mthudaa/10bit_SAR-ADC_ITS/xschem/x10b_adc.pdf

### x10b_adc.sch

# cdac

x2

### VDD

### VSS

### VCM

CF[0:9]

### SWP_IN[0:9]

### SWN_IN[0:9]

### VCP

### VCN

# th_dif_sw

x3

### VDD

### VSS

CK

### CKB

### VIP

### VIN

### VCP

### VCN

## SWP[0:9] SWN[0:9] DATA[0:9] CKO

## CKSB

## CKS

## CKSB

## CKS

## VDDD VSSD

## RDY CMP_P CMP_N

## CMP_P CMP_N

## VINP VINN

## VCP VCN

## VCP VCN

## VCP VCN

## SWP[0:9] SWN[0:9]

CF[0:9]

## VDDA VSSA

## VDDA VSSA

## CLK

## VDDR VSSR VCM

# VDDA VSSA

# CLK VINP VINN

# DATA[0:9] CKO

CF[0:9]

# VCM

EN

EN | RDY

## CLK

# tdc

x1

### CLK

### VDD

### VSS

### VINP

### VINN

### OUTP

### OUTN

### RDY

# sar10b

x4

### VPWR

### VGND

### CLK

### RDY

### CMP_P

### CMP_N

EN

### CKS

### CKSB

CF[0:9]

### SWP[0:9]

### SWN[0:9]

### DATA[0:9]

### CKO

# VDDD VSSD VDDR VSSR

s1

.include /usr/local/share/pdk/sky130A/libs.ref/sky130_fd_sc_hs/spice/sky130_fd_sc_hs.spice

### cdac.sch

# VCM

# VDD

# VSS

CF[0:9]

# SWP_IN[0:9]

# SWN_IN[0:9]

# VCN

# VCP

# VDD

# VCM

# VSS

CF[0:9]

# SWP_IN[0:9] SWN_IN[0:9] VCP VCN

# single_10b_cdac

x3

## VDD

CF[0:9]

## SW_IN[0:9]

## VCM

## VSS

VC

# VCM

# VDD

# VSS

CF[0:9]

# single_10b_cdac

x4

## VDD

CF[0:9]

## SW_IN[0:9]

## VCM

## VSS

VC

### th_dif_sw.sch

# th_sw

x1

# VDD

# VSS

CK

# CKB

IN

# OUT

# VDD VSS CK_BUFF CKB_BUFF VIP

# VCP

# th_sw

x2

# VDD

# VSS

CK

# CKB

IN

# OUT

# VDD VSS CK_BUFF CKB_BUFF VIN

# VCN

# VDD VSS

CK

# CKB VIP VIN

# VCP VCN

A | X

x3

# buf_16

A | X

x4

buf_16 CK | CKBCK_BUFF | CKB_BUFF

### tdc.sch

# OUTN

# OUTP

# delay_gate_ori

x2

IN

# VDD

# VSS

# VINP

# VINN

# OUT

# INP

# delay_gate_ori

x3

IN

# VDD

# VSS

# VINP

# VINN

# OUT

# INN

# VDD

# VDD

# VSS

# VSS

# VINP

# VINP

# VINN

# VINN

# CLK

# CLK

# VDD VSS VINP VINN

# CLK

# OUTP OUTN

# phase_detector

x1

# VDD

# VSS

# INP

# INN

# OUTP

# OUTN

# RDY

# VDD VSS INP INN

# RDY

# RDY

### single_10b_cdac.sch

# x10b_cap_array

x2

## vcm

sw[0:9]

vc

VCM | VC

# VDD

CF[0:9]

# SW_IN[0:9] VCM VSS

VC

# SWN[0:9]

# cdac_sw_10b

x1

## VDD

CF[0:9]

## SW_IN[0:9]

## VCM

## VSS

## SWN[0:9]

# VDD

CF[0:9]

# SW_IN[0:9] VCM VSS

# SWN[0:9]

### th_sw.sch

# VDD VSS

CK

# CKB

IN

OUT | th_sw_main

x1

# VSS

CK

# VGS

IN

# OUT

# bootstrap

x2

# VDD

# VSS

CK

# CKB

IN

# VGS

# VSS

CK

# VGS

IN

# OUT

# VDD VSS

CK

# CKB

IN

# VGS

### delay_gate_ori.sch

## VDD

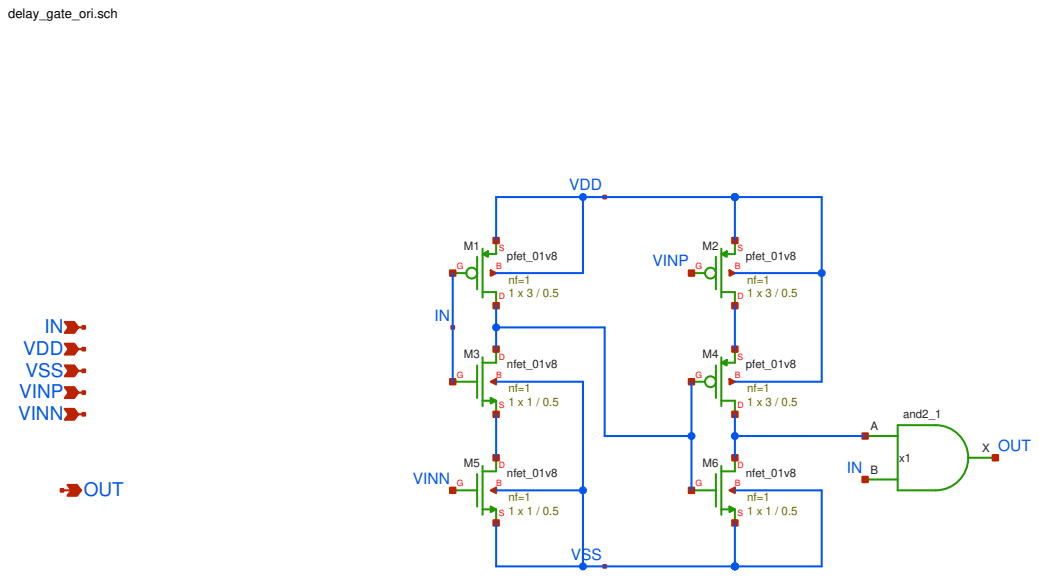
[picture p1: page 7]
VINP; VINN; OUT; VINP VINN; VSS; VDD; and2_1; pfet_01v8; nfet_01v8

### phase_detector.sch

# VDD

# INP INN

# VSS

# OUTP OUTN RDY

# pd_in

x1

# VDD

# VSS

# INP

# INN

AB

# pd_out

x2

# VDD

# VSS AB

# OUTP

# OUTN

# RDY

# VDD VSS INP INN

AB

# VDD VSSAB

# OUTP OUTN RDY

### x10b_cap_array.sch

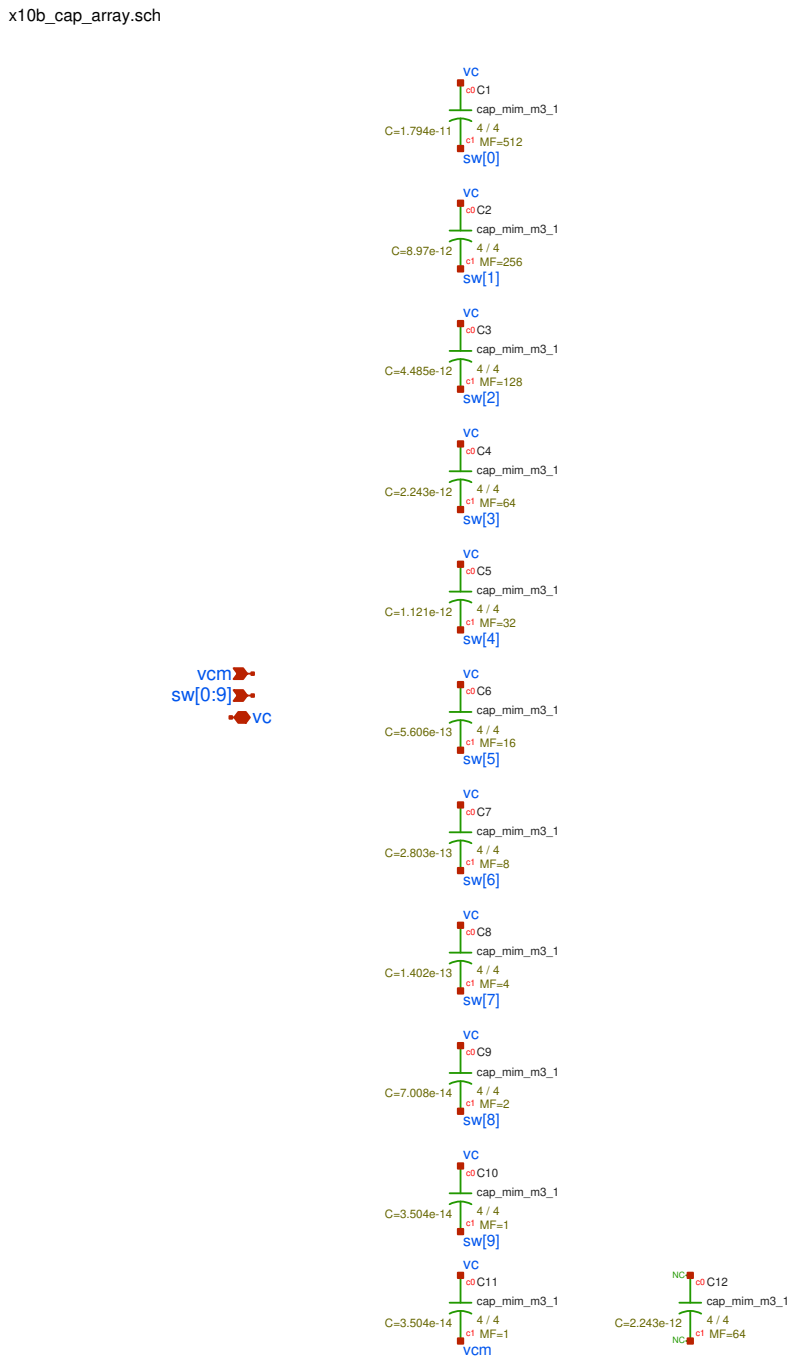
[picture p2: page 9]

### cdac_sw_10b.sch

VDD
CF[0:9]
SW_IN[0:9]
VCM
VSS
SWN[0:9]

cdac_sw_1

x1

vdda

cki

bi

vcm

vssa

dac_out

VDD

VSS

SWN[0]

VCM

CF[0]
SW_IN[0]
cdac_sw_3

x3

VDDA

CKI

BI

VCM

VSSA

DAC_OUT

VDD

VSS

SWN[2]

VCM

CF[2]
SW_IN[2]
cdac_sw_5

x4

vdda

cki

bi

vcm

vssa

dac_out

VDD

VSS

SWN[4]

VCM

CF[4]
SW_IN[4]
cdac_sw_7

x5

vdda

cki

bi

vcm

vssa

dac_out

VDD

VSS

SWN[6]

VCM

CF[6]
SW_IN[6]
cdac_sw_9

x6

vdda

cki

bi

vcm

vssa

dac_out

VDD

VSS

SWN[8]

VCM

CF[8]
SW_IN[8]

cdac_sw_2

x7

vdda

cki

bi

vcm

vssa

dac_out

VDD

VSS

SWN[1]

VCM

CF[1]
SW_IN[1]
cdac_sw_4

x8

vdda

cki

bi

vcm

vssa

dac_out

VDD

VSS

SWN[3]

VCM

CF[3]
SW_IN[3]
cdac_sw_6

x9

vdda

cki

bi

vcm

vssa

dac_out

VDD

VSS

SWN[5]

VCM

CF[5]
SW_IN[5]
cdac_sw_8

x10

vdda

cki

bi

vcm

vssa

dac_out

VDD

VSS

SWN[7]

VCM

CF[7]
SW_IN[7]
cdac_sw_10

x11

vdda

cki

bi

vcm

vssa

dac_out

VDD

VSS

SWN[9]

VCM

CF[9]
SW_IN[9]

### th_sw_main.sch

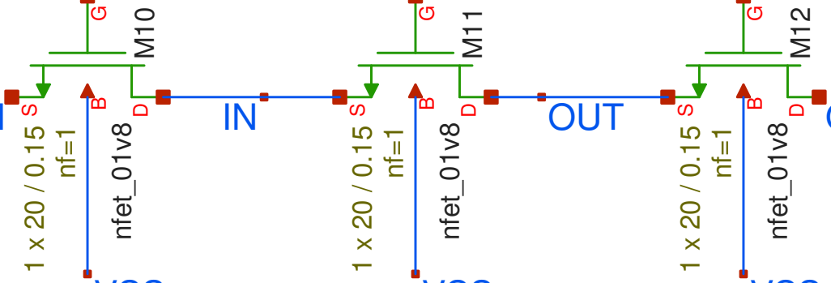
[picture p3: figure]
OUT; nfet_01v8

# VSS

# VGS

# VSS

CK

IN

# VSS

# OUT

CK

# VSS

CK

# VGS

IN

# OUT

### bootstrap.sch

CK

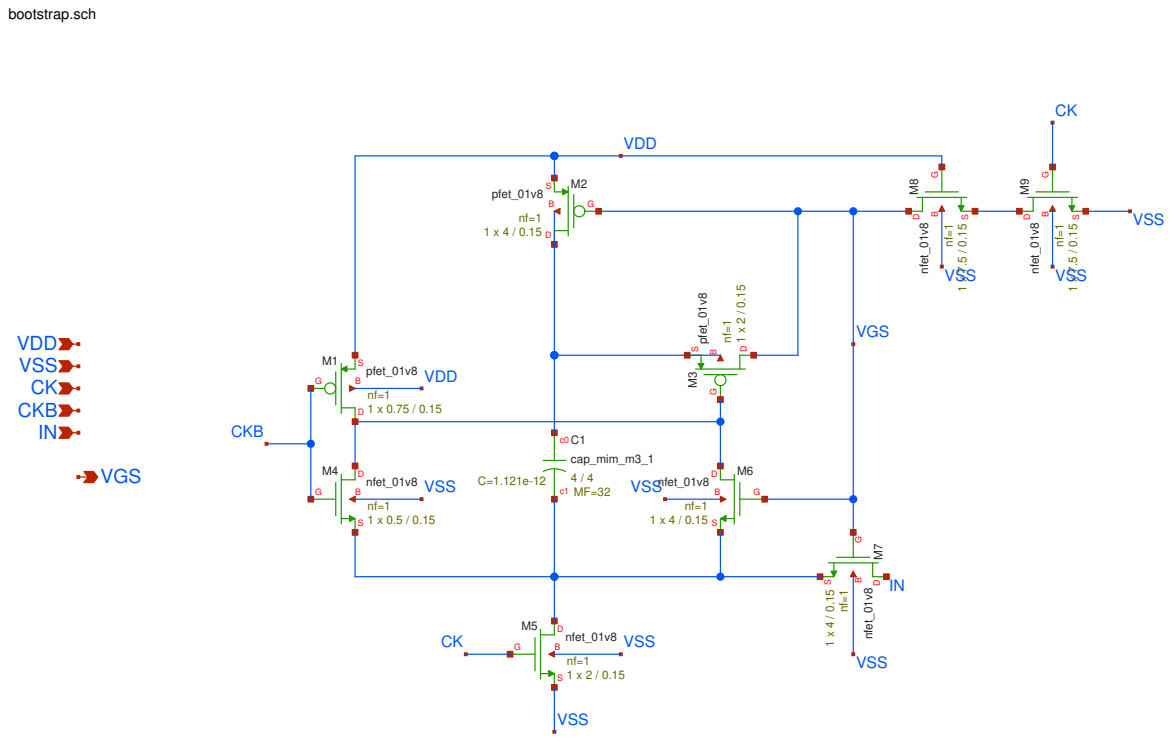
[picture p4: page 12]
VDD VSS CK CKB IN; VGS; pfet_01v8; nfet_01v8; cap_mim_m3_1; VDD; VSS; CKB

### pd_in.sch

# VDD

# INP INN

# VSS

AB

# pd_in_half

x1

# VDD

# VSS

IN

# INB

# OUTB

# OUT

# pd_in_half

x2

# VDD

# VSS

IN

# INB

# OUTB

# OUT

# VDD VSS INP INN

BA

# VDD VSS

# INP

# INNBA

### pd_out.sch

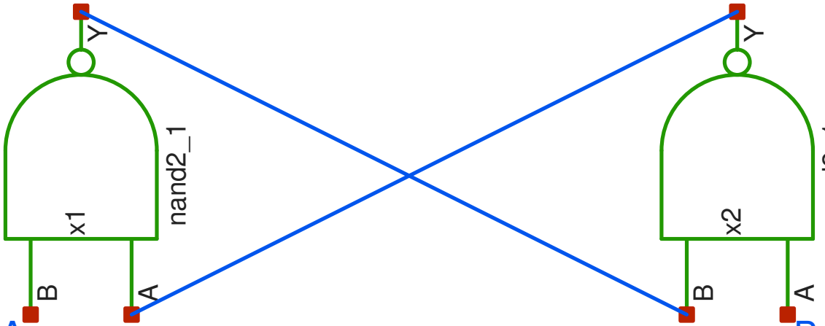
[picture p5: figure]
nand2_1

# nand2_1

# OUTPOUTN

A | B

A

B

X
x3

# xor2_1 A

B

# RDY

# OUTN

# OUTP

# RDY

A
B

# VSS

# VDD

### cdac_sw_1.sch

nooverlap_clk

x1

VDD

IN

VSS

CLK0

CLKB0

CLK1

CLKB1

tg_sw_1

x2

vdd

swp

swn

vss

in

out

dac_sw_1

x3

vdd

in

ck

ckb

vss

out

vdda

vdda

vdda

vssa

vssa

vssa

clkb0

clk0

clk0
clkb0

clk1

clkb1

clk1
clkb1

vcm

bi

cki

vdda

cki

bi

vcm
dac_out
vssa

dac_out

tg_sw_1

x4

vdd

swp

swn

vss

in

out

vdda

vssa

clk1
clkb1 | tg_sw_1

x5

vdd

swp

swn

vss

in

out

vdda

vssa

clk1
clkb1
vcm | dac_out

### cdac_sw_3.sch

nooverlap_clk

x1

VDD

IN

VSS

CLK0

CLKB0

CLK1

CLKB1

tg_sw_3

x2

vdd

swp

swn

vss

in

out

dac_sw_3

x3

vdd

in

ck

ckb

vss

out

VDDA

VDDA

VDDA

VSSA

VSSA

VSSA

clkb0

clk0

clk0
clkb0

clk1

clkb1

clk1
clkb1

VCM

BI

CKI

VDDA

CKI

BI

VCM
DAC_OUT
VSSA

DAC_OUT

tg_sw_3

x4

vdd

swp

swn

vss

in

out

VDDA

VSSA

clk1
clkb1 | tg_sw_3

x5

vdd

swp

swn

vss

in

out

VDDA

VSSA

clk1
clkb1
VCM | DAC_OUT

### cdac_sw_5.sch

nooverlap_clk

x1

VDD

IN

VSS

CLK0

CLKB0

CLK1

CLKB1

tg_sw_5

x2

vdd

swp

swn

vss

in

out

dac_sw_5

x3

vdd

in

ck

ckb

vss

out

vdda

vdda

vdda

vssa

vssa

vssa

clkb0

clk0

clk0
clkb0

clk1

clkb1

clk1
clkb1

vcm

bi

cki

### vdda

### cki

bi

### vcm

dac_out

### vssa

### dac_out

tg_sw_5

x4

vdd

swp

swn

vss

in

out

vdda

vssa

clk1
clkb1

vcm

tg_sw_5

x5

vdd

swp

swn

vss

in

out

vdda

vssa

clk1
clkb1

dac_out

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

clkb0

clk0

clk0
clkb0

clk1

clkb1

clk1
clkb1

vcm

bi

cki

### vdda

### cki

bi

### vcm

dac_out

### vssa

### dac_out

tg_sw_10

x4
vdd

swp

swn

vss

in

out

vdda

vssa

clk1
clkb1 | tg_sw_10

x5
vdd

swp

swn

vss

in

out

vdda

vssa

clk1
clkb1
vcm | dac_out

### pd_in_half.sch

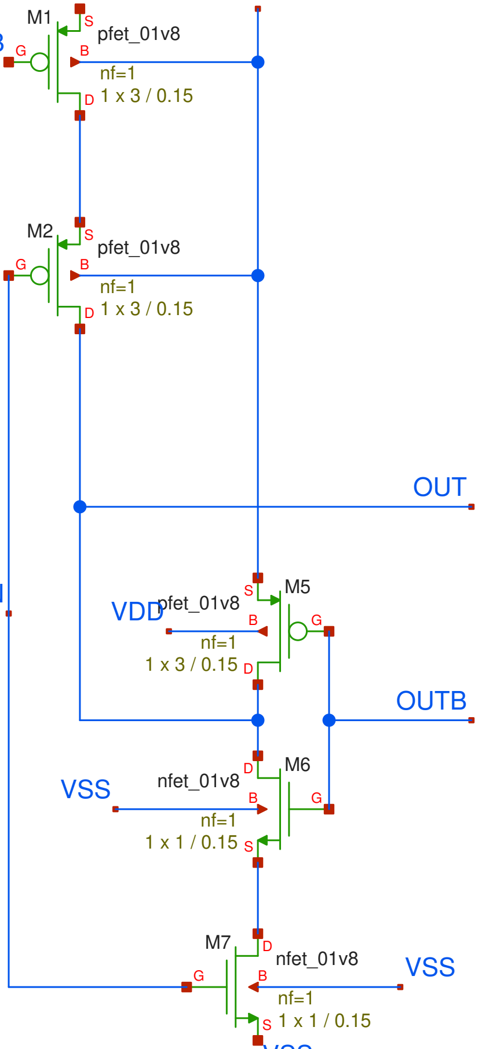
[picture p6: figure]
nfet_01v8; VSS; pfet_01v8; VDD; OUT; OUTB

IN

# INB

# VDD

IN

# INB

# VSS

# OUT

# OUTB

# VSS

VDD | VDD

### nooverlap_clk.sch

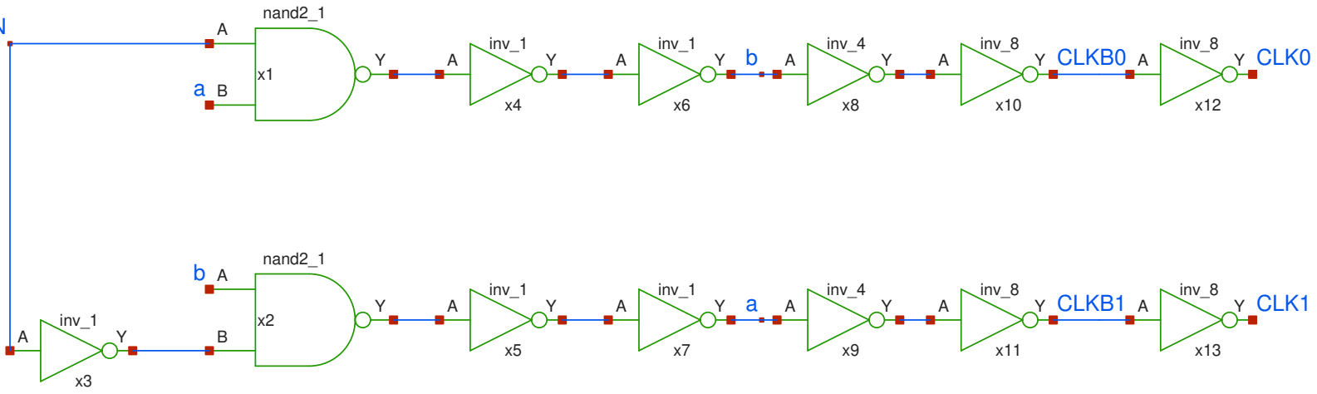
[picture p7: figure]
nand2_1; inv_1; inv_4; inv_8; CLK0CLKB0; CLK1CLKB1

IN

## VDD

IN

## VSS

## CLK0

## CLKB0

## CLK1

## CLKB1

### tg_sw_1.sch

# vdd

# swp

# swn

# vss

in

# out

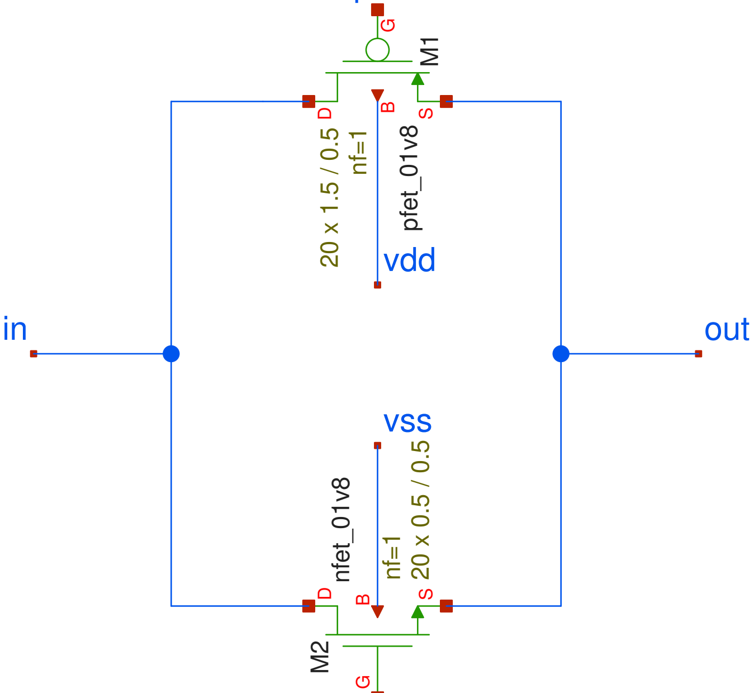
[picture p8: figure]
vdd; vss; outin; S pfet_01v8; nfet_01v8

# swn

# swp

### dac_sw_1.sch

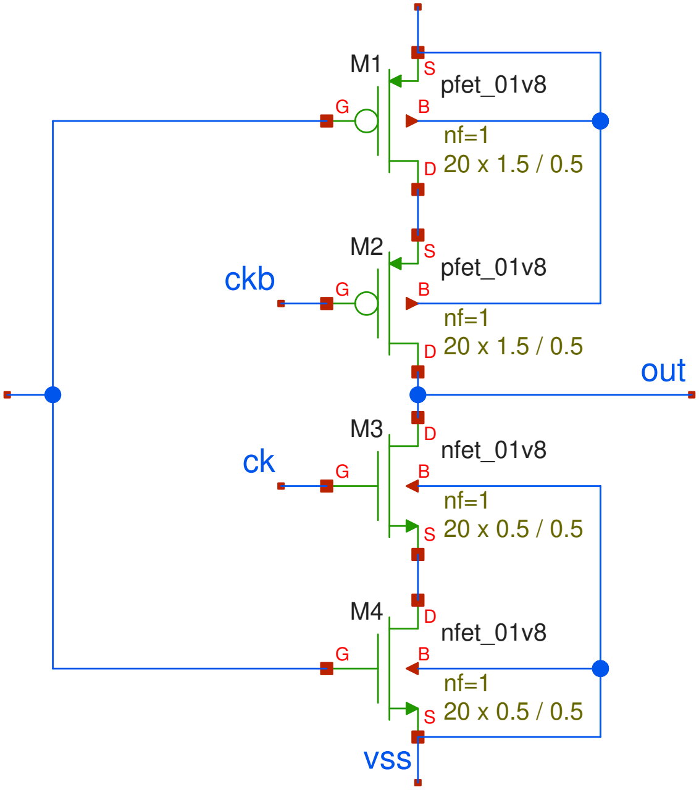
[picture p9: figure]
vss; out; ckb; pfet_01v8; nfet_01v8

in

# vdd

# vdd

in

ck

# ckb

# vss

# out

### tg_sw_3.sch

# vdd

# swp

# swn

# vss

in

# out

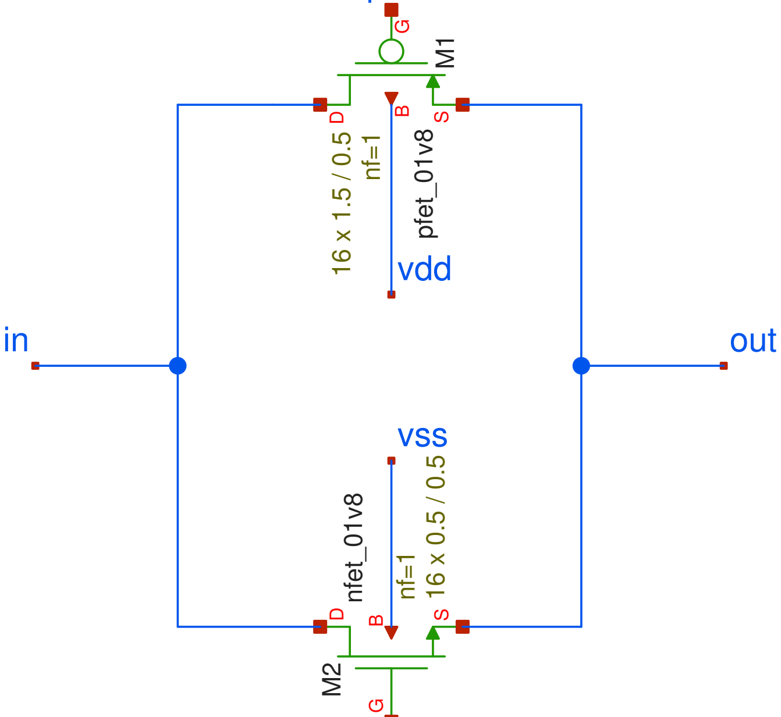
[picture p10: figure]
vdd; vss; outin; S pfet_01v8; nfet_01v8

# swn

# swp

### dac_sw_3.sch

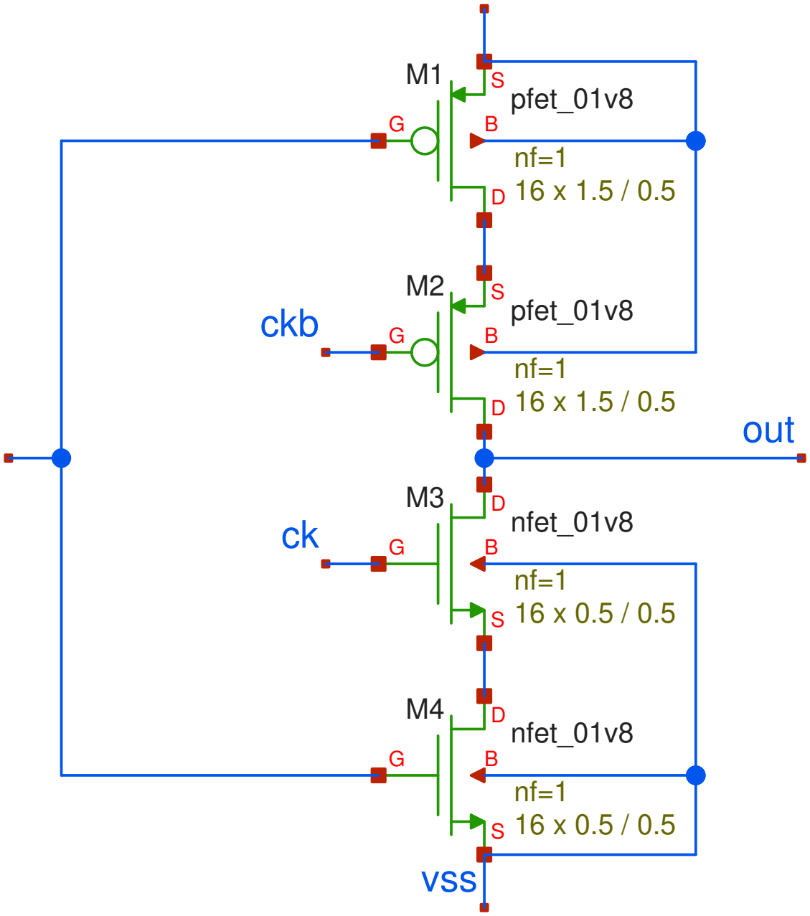
[picture p11: figure]
vss; out; ckb; pfet_01v8; nfet_01v8

in

# vdd

# vdd

in

ck

# ckb

# vss

# out

### tg_sw_5.sch

# vdd

# swp

# swn

# vss

in

# out

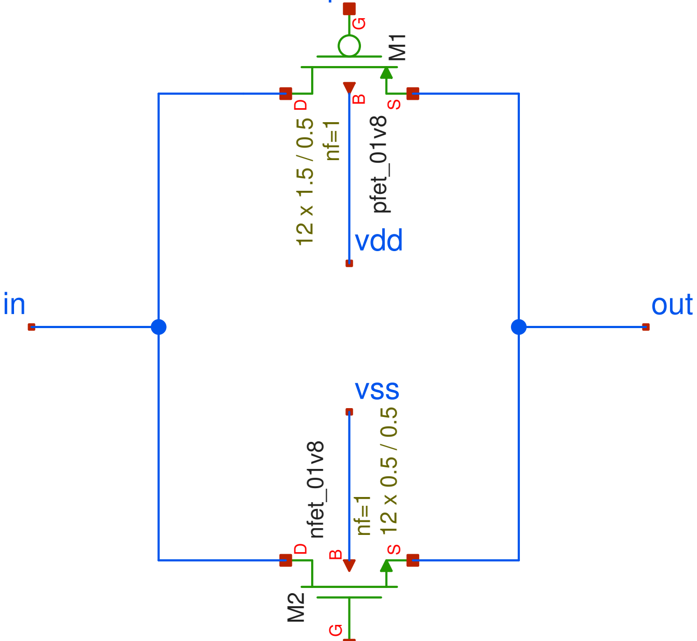
[picture p12: figure]
vdd; vss; outin; S pfet_01v8; nfet_01v8

# swn

# swp

### dac_sw_5.sch

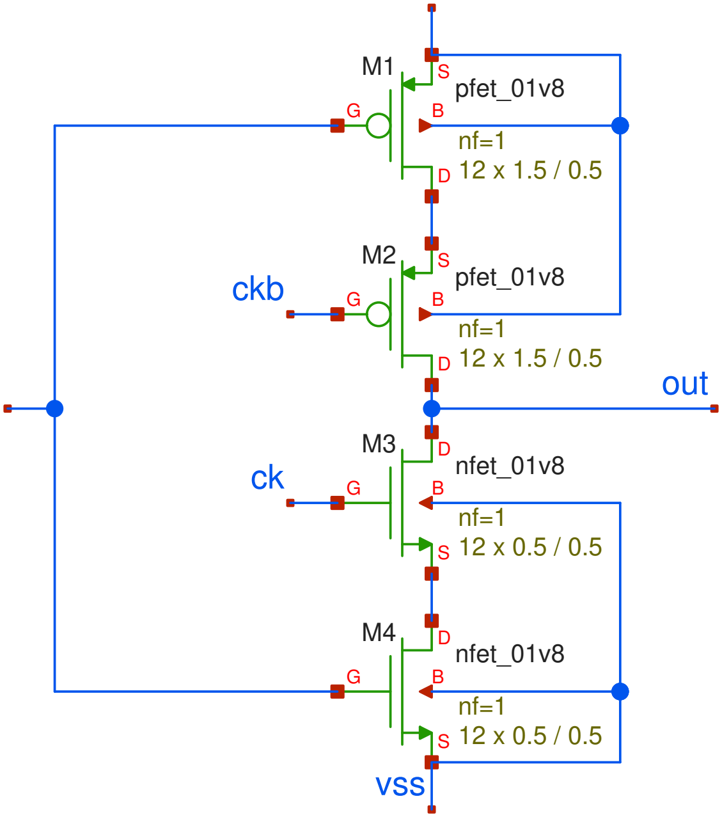
[picture p13: figure]
vss; out; ckb; pfet_01v8; nfet_01v8

in

# vdd

# vdd

in

ck

# ckb

# vss

# out

### tg_sw_7.sch

# vdd

# swp

# swn

# vss

in

# out

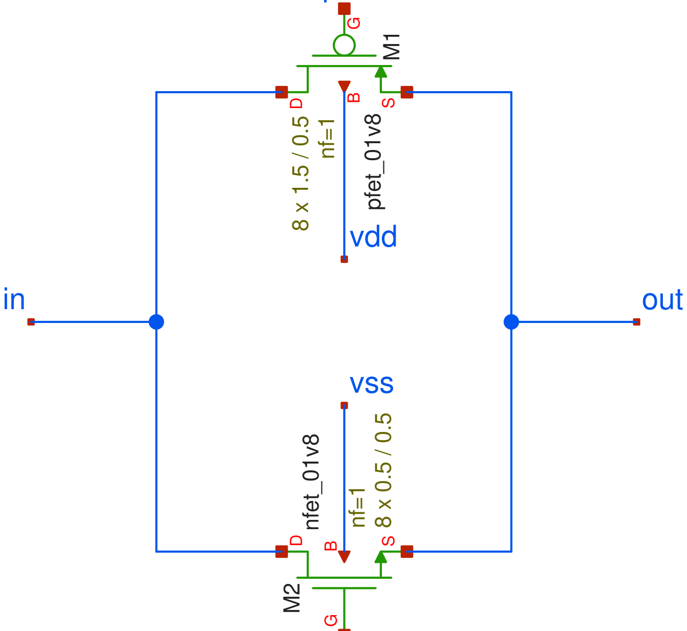
[picture p14: figure]
vdd; vss; outin; S pfet_01v8; nfet_01v8

# swn

# swp

### dac_sw_7.sch

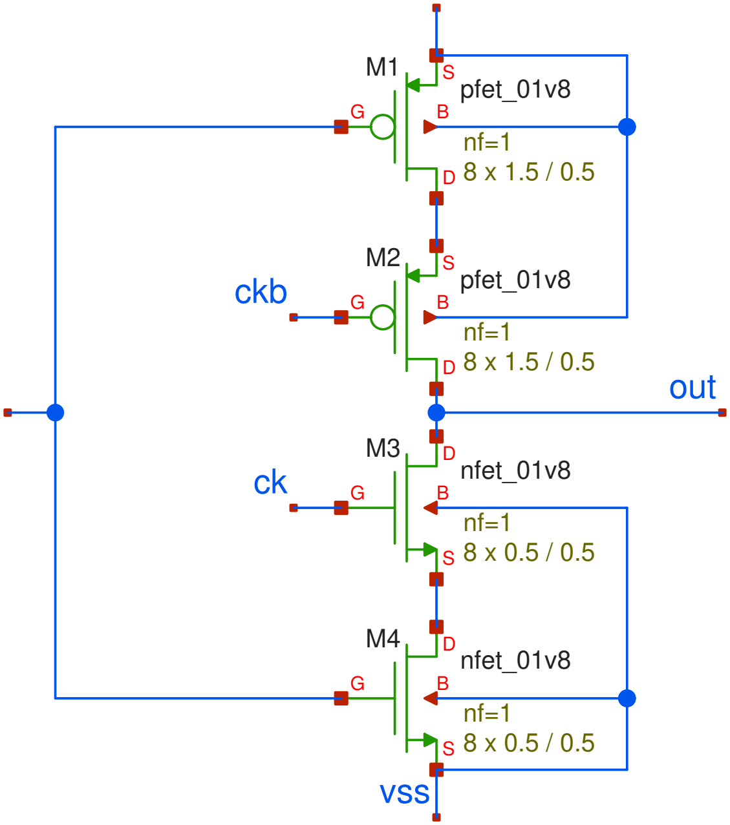
[picture p15: figure]
vss; out; ckb; pfet_01v8; nfet_01v8

in

# vdd

# vdd

in

ck

# ckb

# vss

# out

### tg_sw_8.sch

# vdd

# swp

# swn

# vss

in

# out

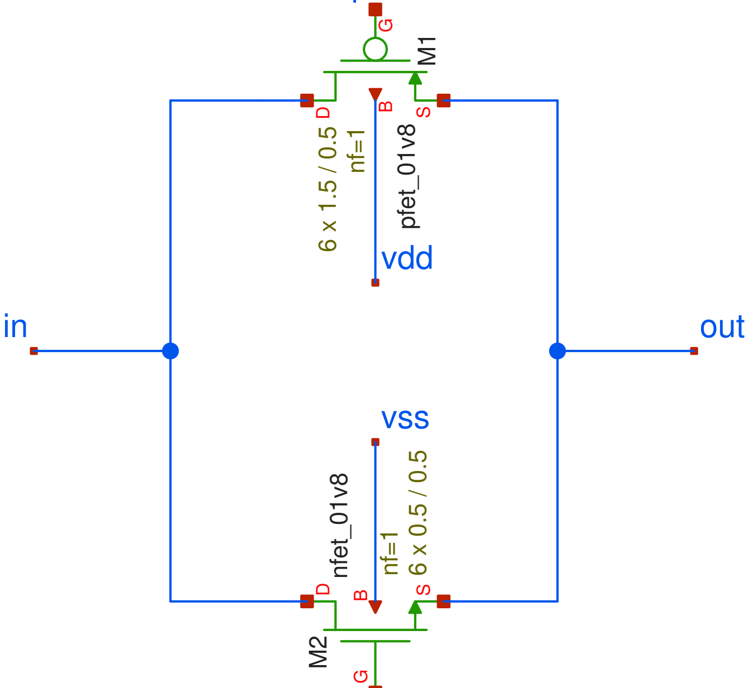
[picture p16: figure]
vdd; vss; outin; S pfet_01v8; nfet_01v8

# swn

# swp

### dac_sw_8.sch

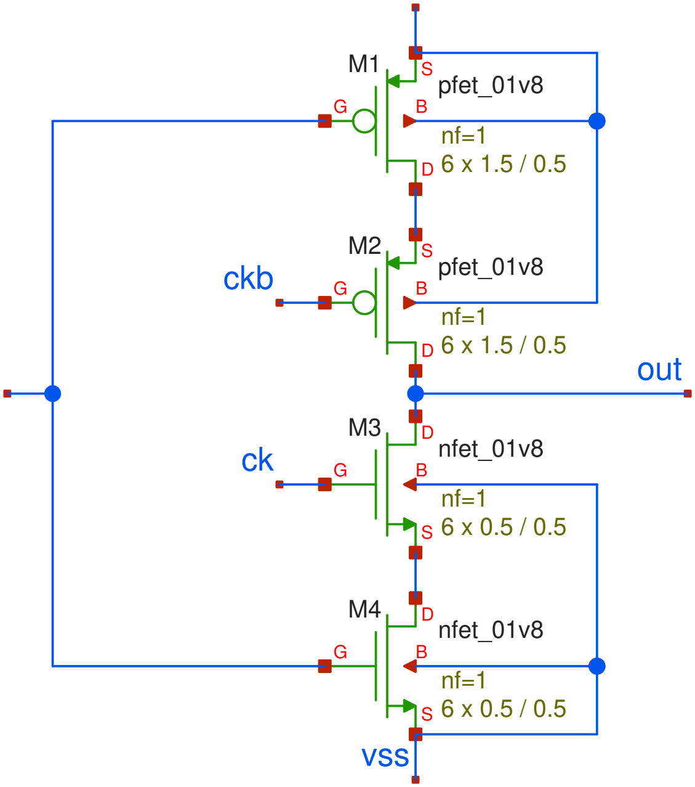
[picture p17: figure]
vss; out; ckb; pfet_01v8; nfet_01v8

in

# vdd

# vdd

in

ck

# ckb

# vss

# out

### tg_sw_2.sch

# vdd

# swp

# swn

# vss

in

# out

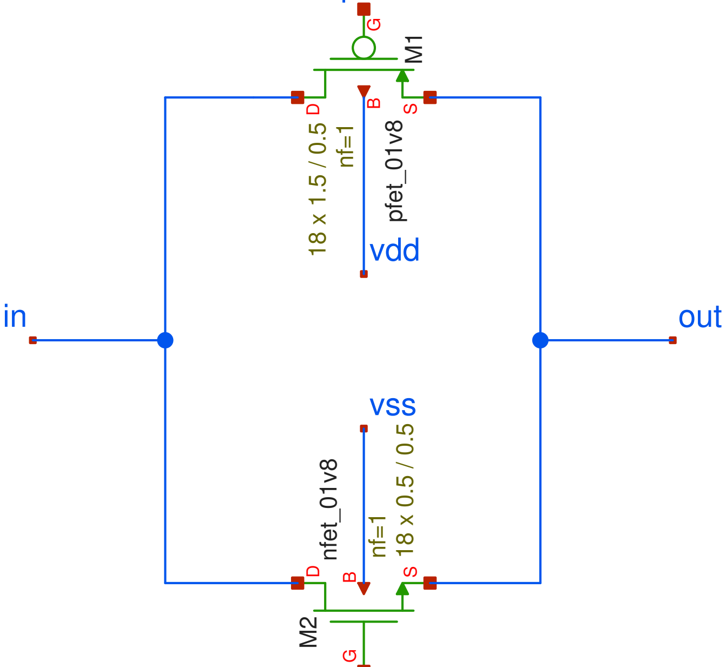
[picture p18: figure]
vdd; vss; outin; S pfet_01v8; nfet_01v8

# swn

# swp

### dac_sw_2.sch

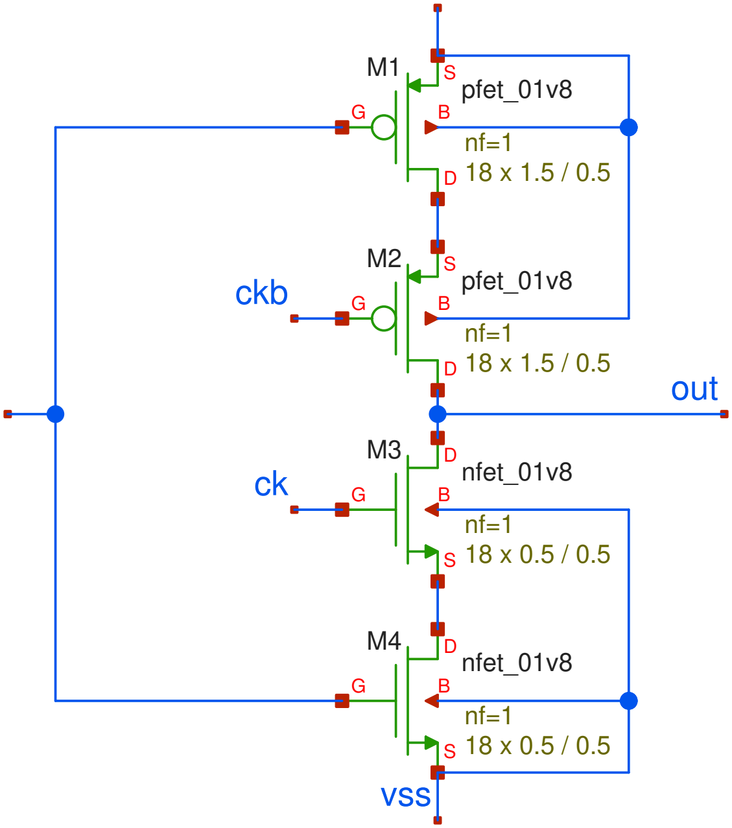
[picture p19: figure]
vss; out; ckb; pfet_01v8; nfet_01v8

in

# vdd

# vdd

in

ck

# ckb

# vss

# out

### tg_sw_4.sch

# vdd

# swp

# swn

# vss

in

# out

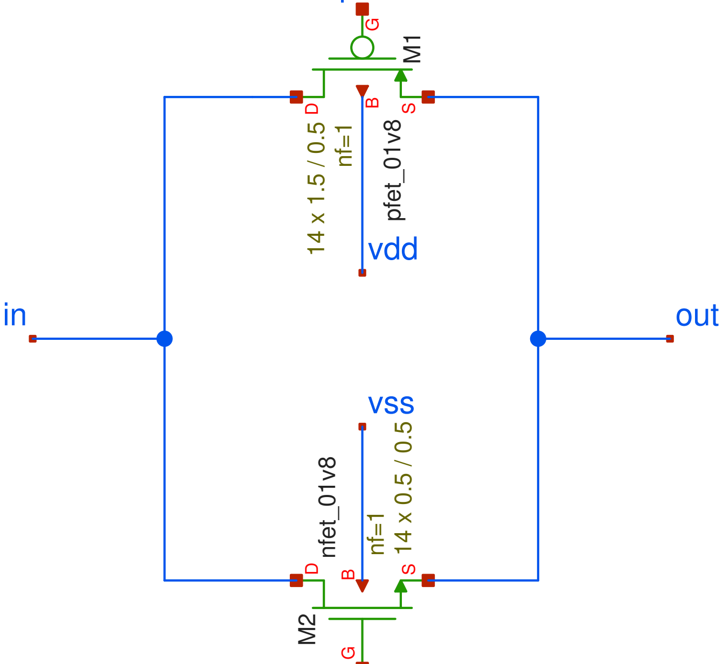
[picture p20: figure]
vdd; vss; outin; S pfet_01v8; nfet_01v8

# swn

# swp

### dac_sw_4.sch

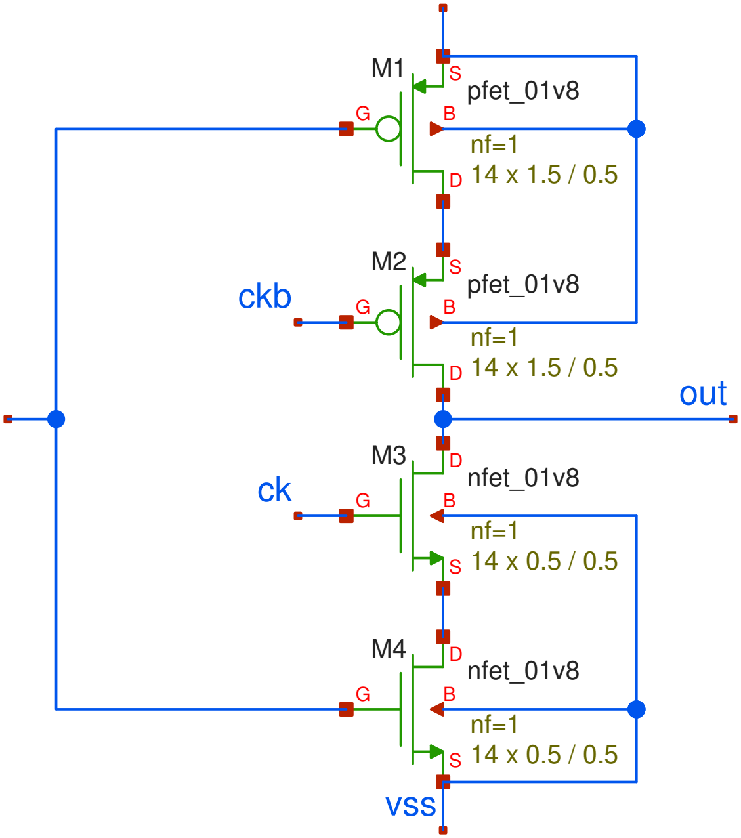
[picture p21: figure]
vss; out; ckb; pfet_01v8; nfet_01v8

in

# vdd

# vdd

in

ck

# ckb

# vss

# out

### tg_sw_10.sch

# vdd

# swp

# swn

# vss

in

# out

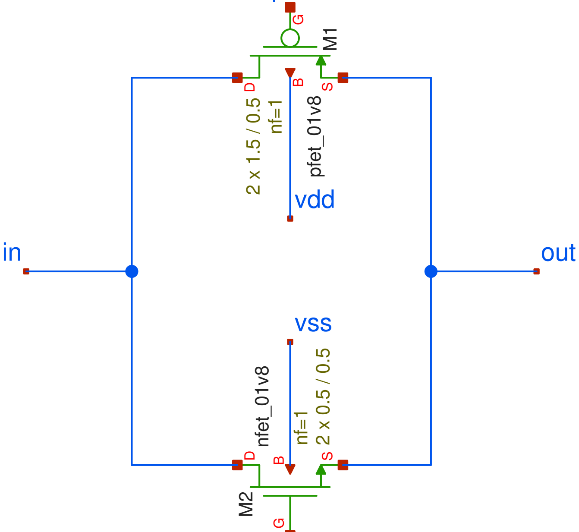
[picture p22: figure]
vdd; vss; outin; S pfet_01v8; nfet_01v8

# swn

# swp

### dac_sw_10.sch

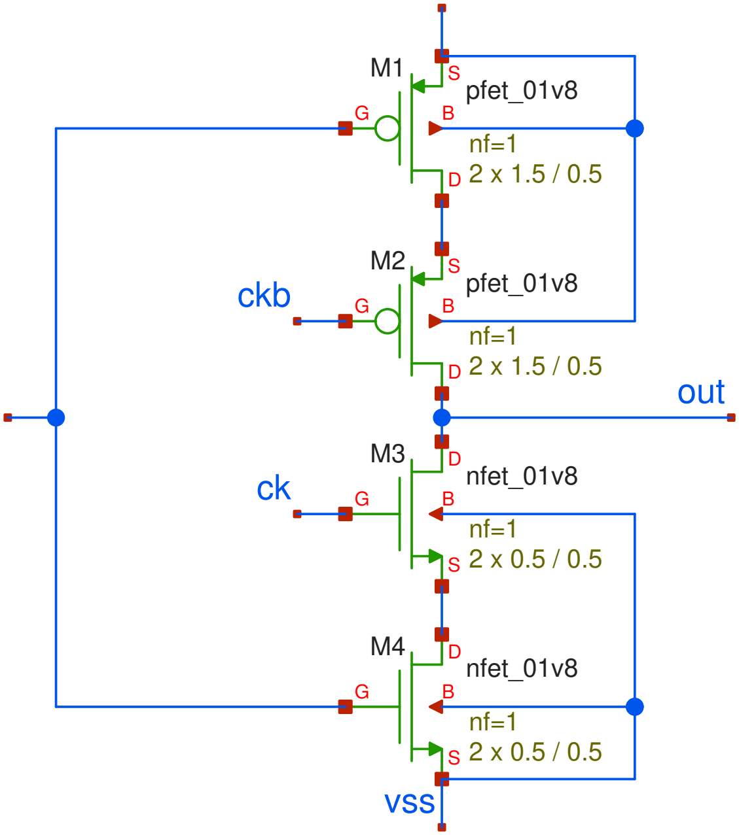
[picture p23: figure]
vss; out; ckb; pfet_01v8; nfet_01v8

in

# vdd

# vdd

in

ck

# ckb

# vss

# out
