mthudaa/10bit_SAR-ADC_ITS/xschem/adc_tb.png

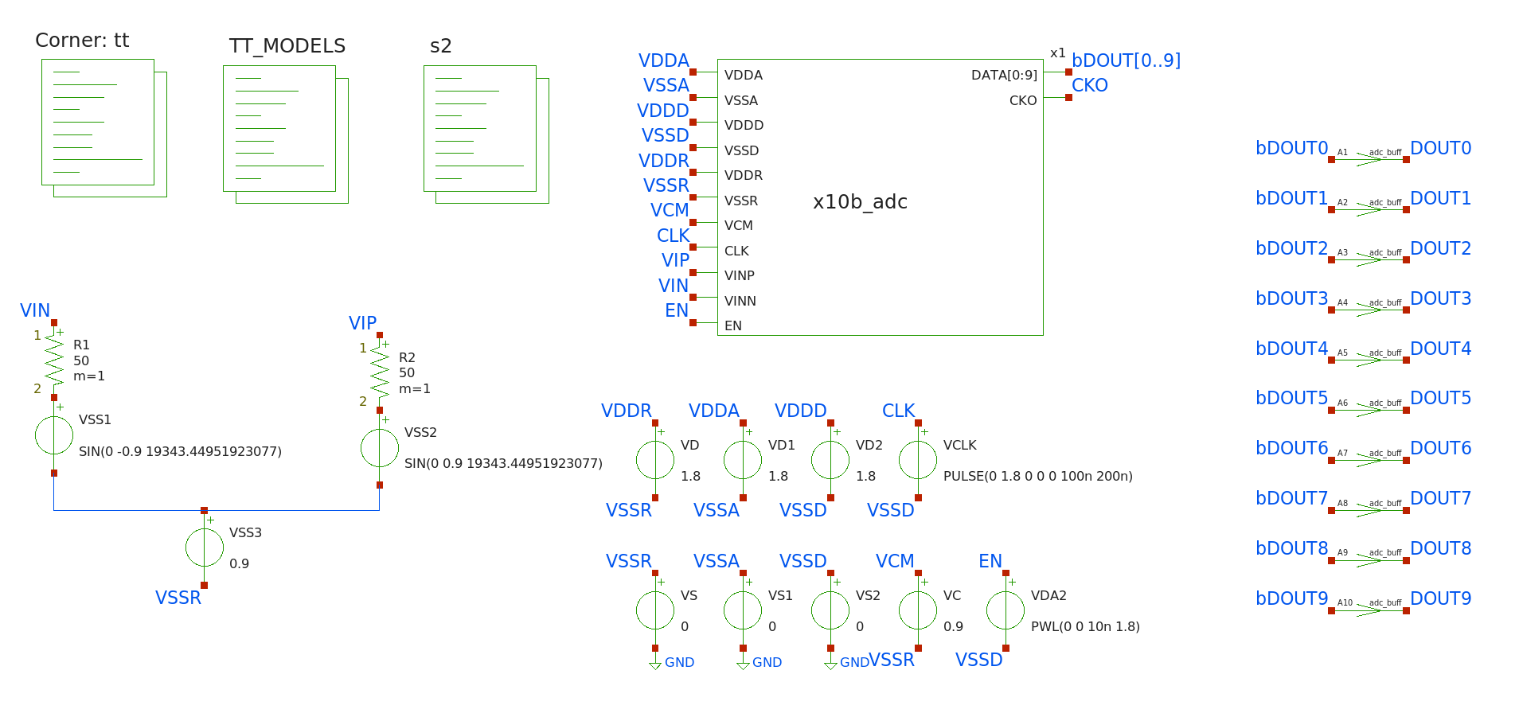
xschem/adc_tb.png
