mthudaa/10bit_SAR-ADC_ITS/xschem/adc_tb_ppg.png

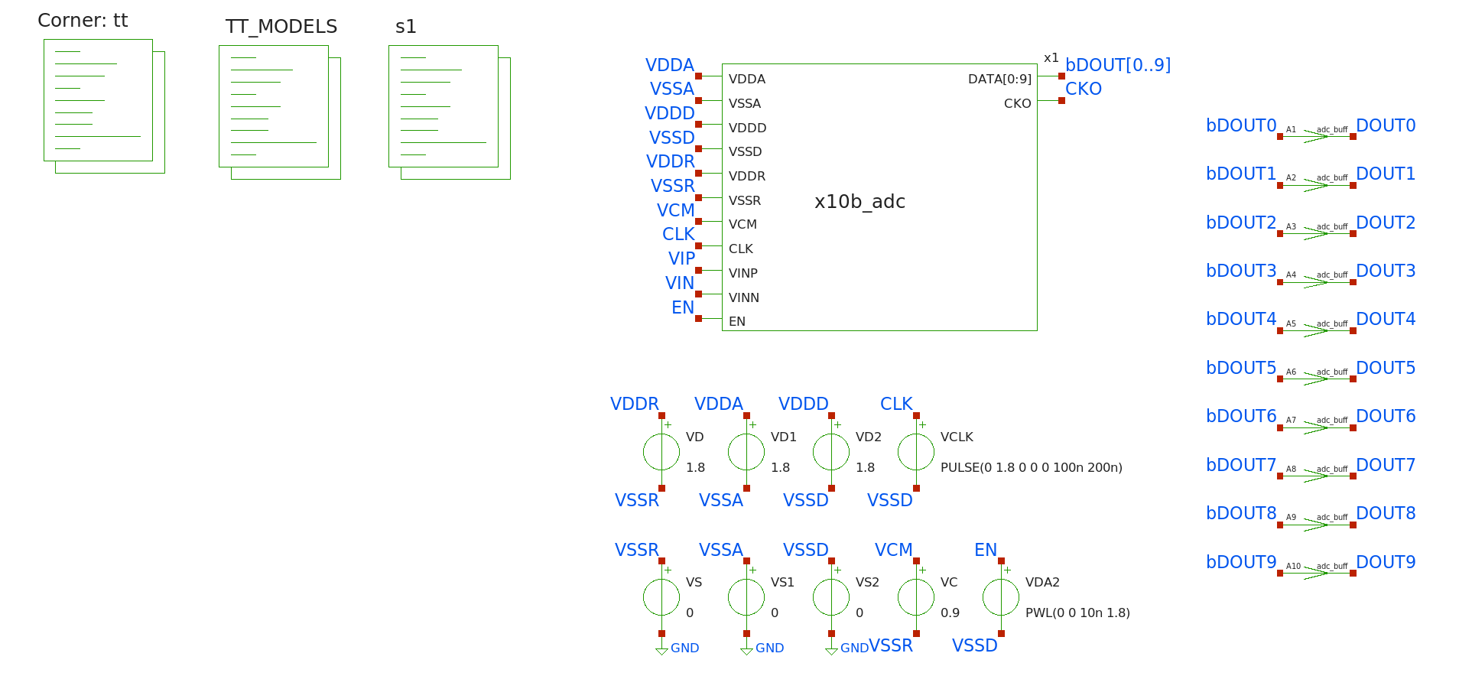
xschem/adc_tb_ppg.png
