mthudaa/10bit_SAR-ADC_ITS/xschem/adc_tb_static.png

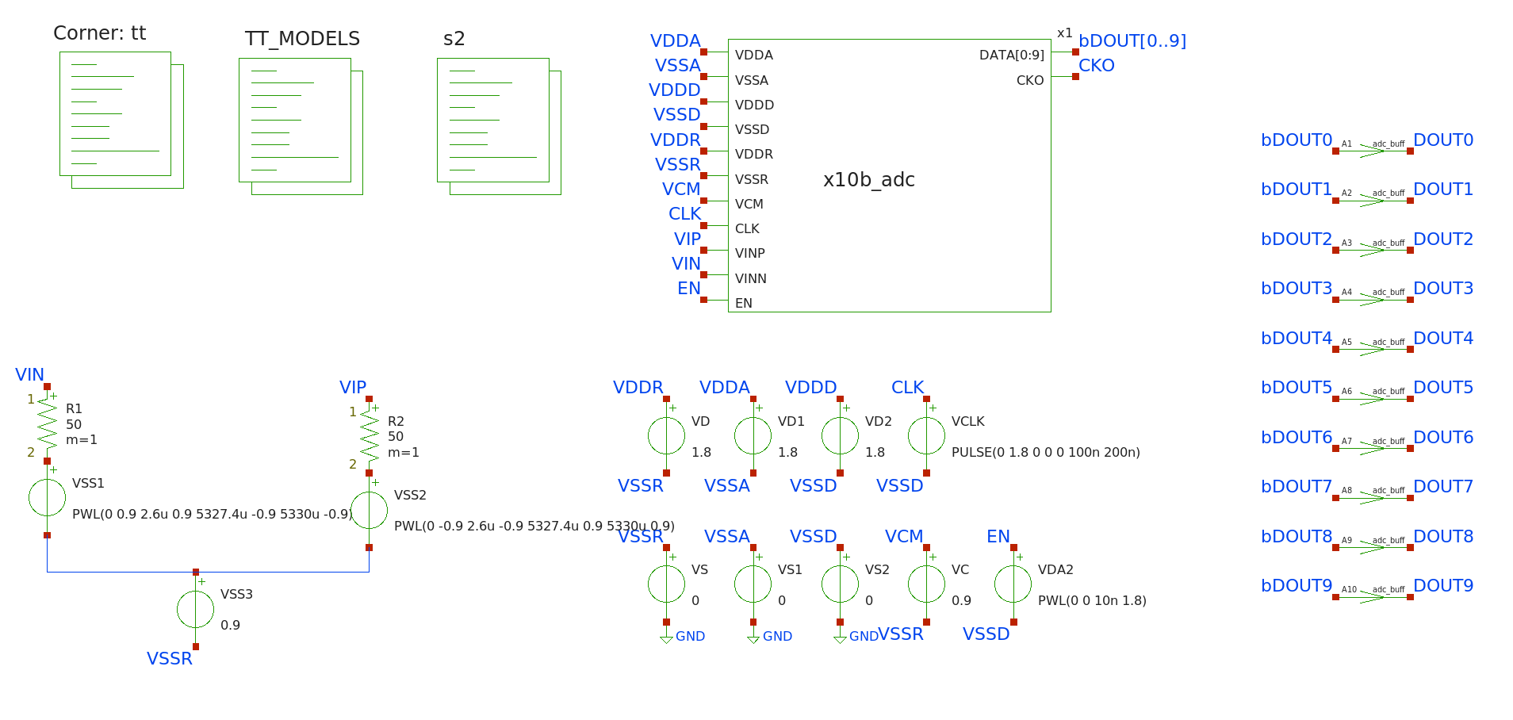
xschem/adc_tb_static.png
