mthudaa/10bit_SAR-ADC_ITS/xschem/bootstrap.png

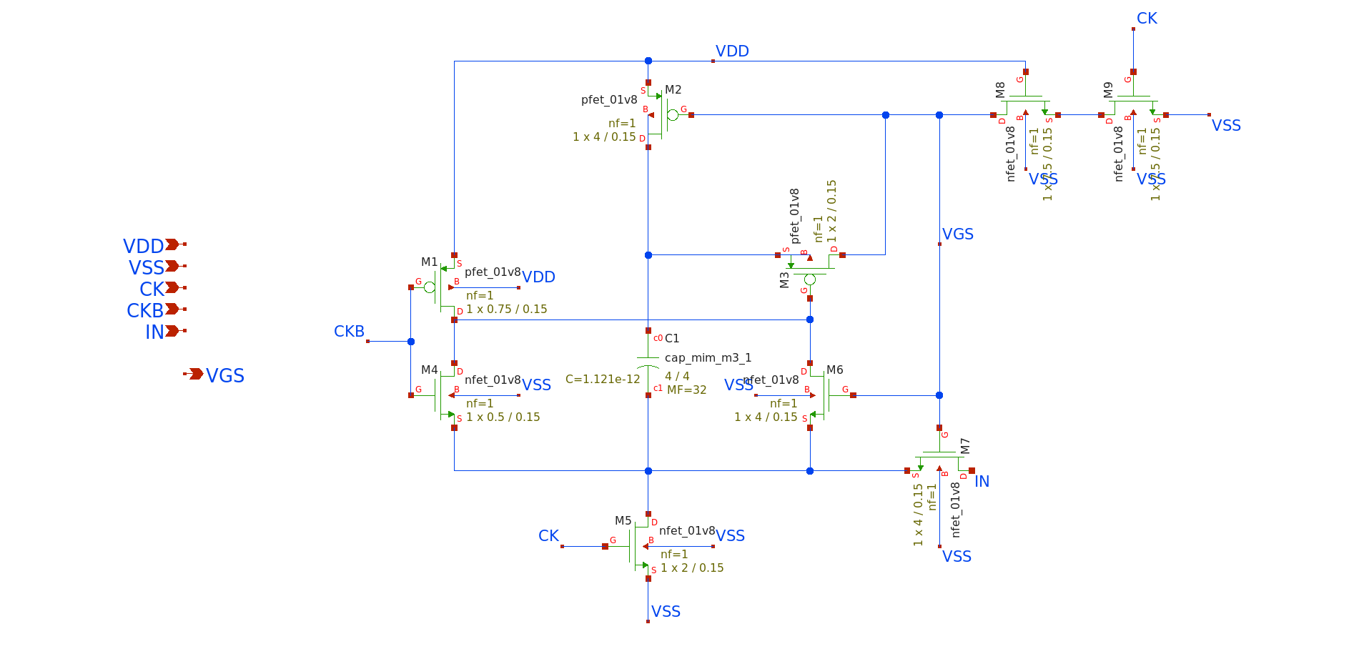
xschem/bootstrap.png
