mthudaa/10bit_SAR-ADC_ITS/xschem/delay_gate_ori.png

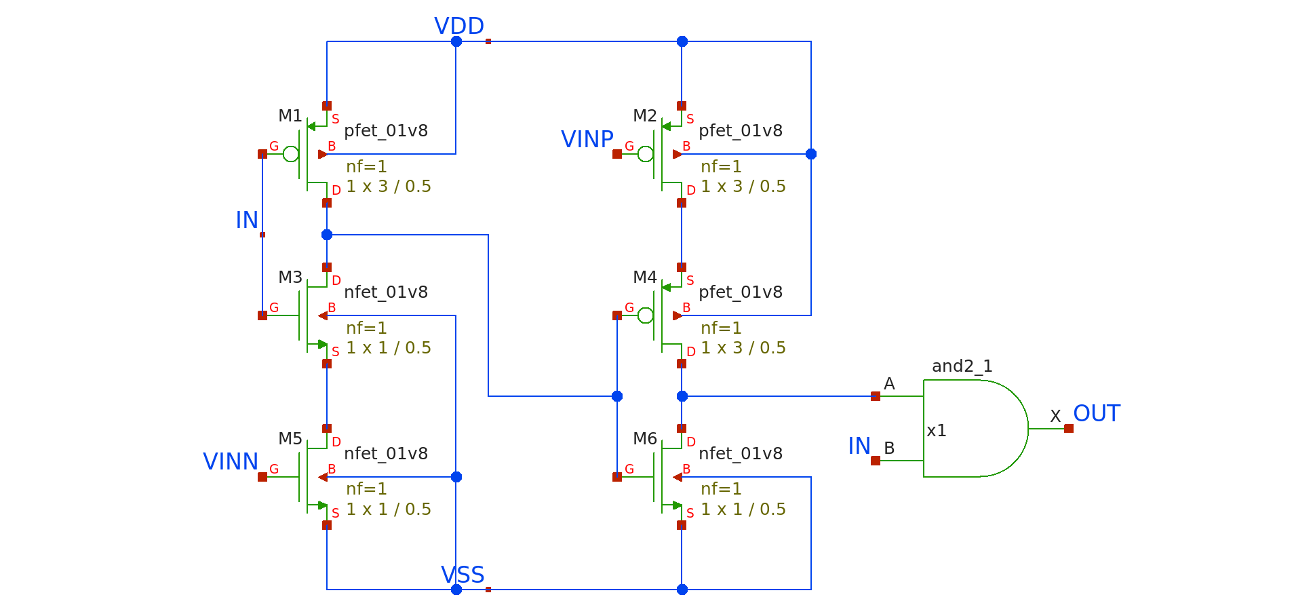
xschem/delay_gate_ori.png
