mthudaa/10bit_SAR-ADC_ITS/xschem/delay_tb.png

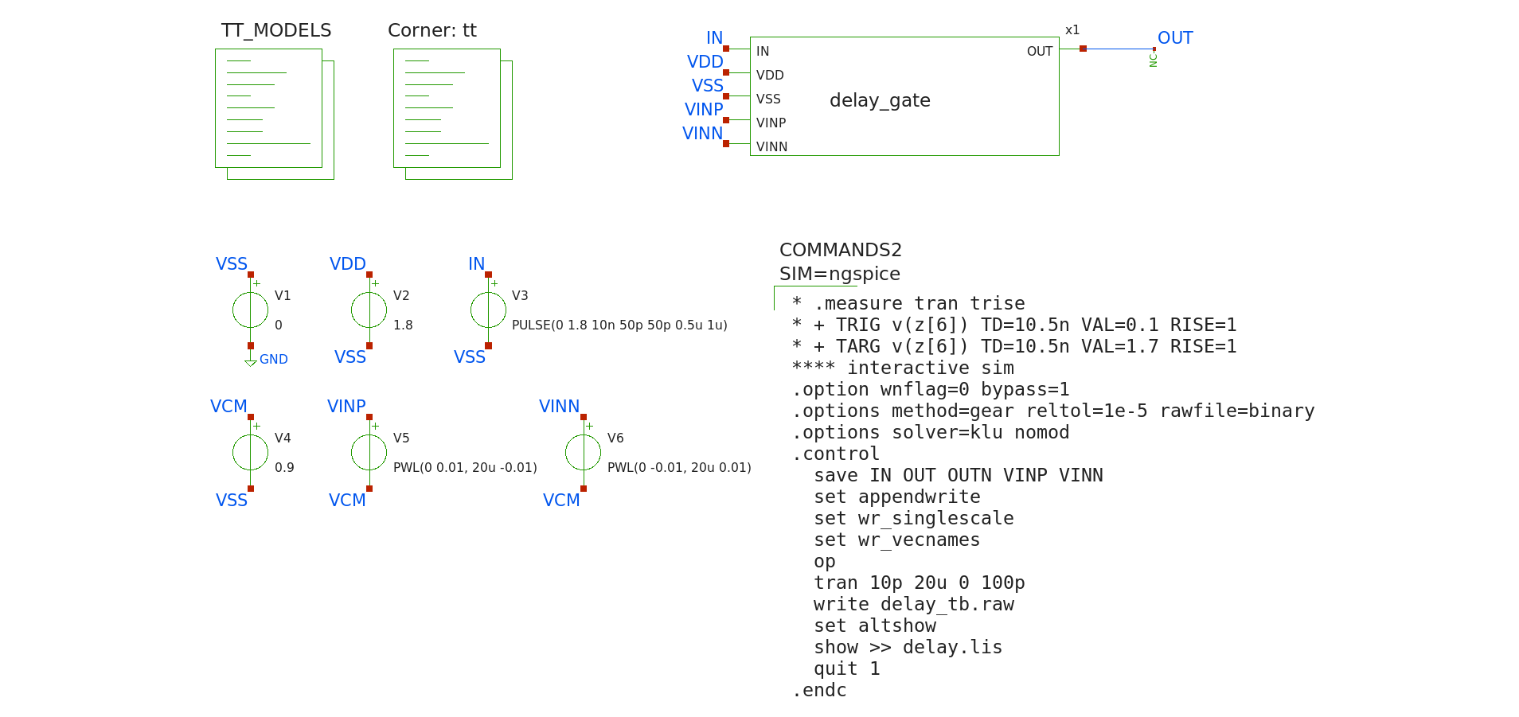
xschem/delay_tb.png
