mthudaa/10bit_SAR-ADC_ITS/xschem/tdc.png

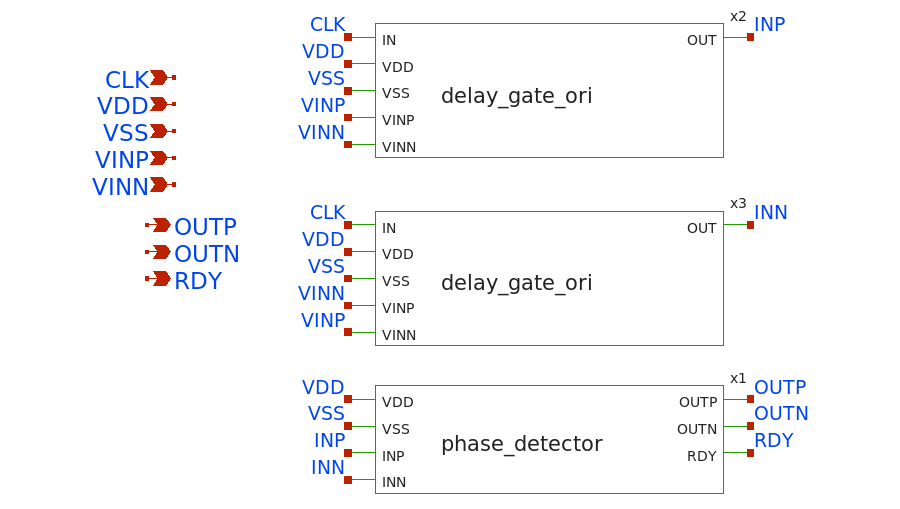
xschem/tdc.png
