mthudaa/10bit_SAR-ADC_ITS/xschem/tdc_tb_ori.png

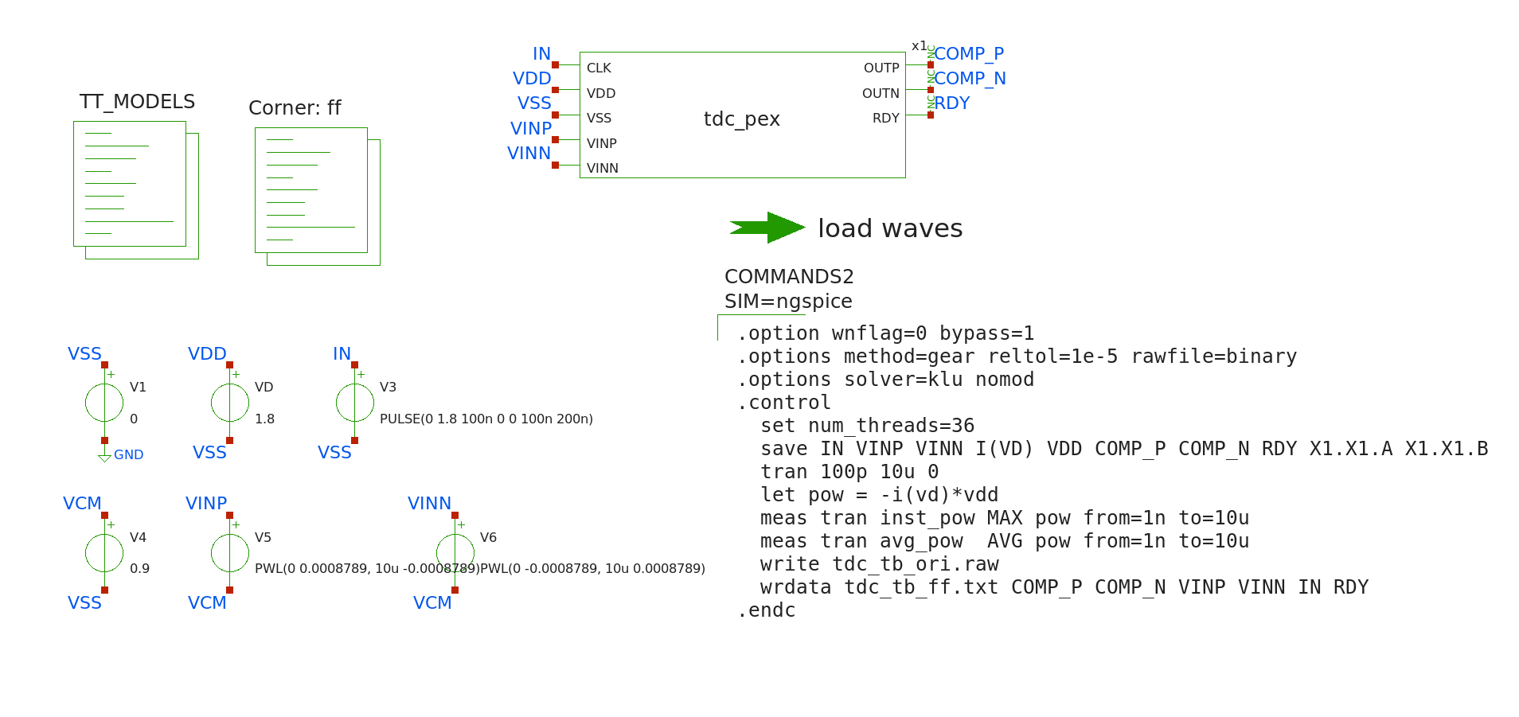
xschem/tdc_tb_ori.png
