mthudaa/10bit_SAR-ADC_ITS/xschem/th_sw_main.png

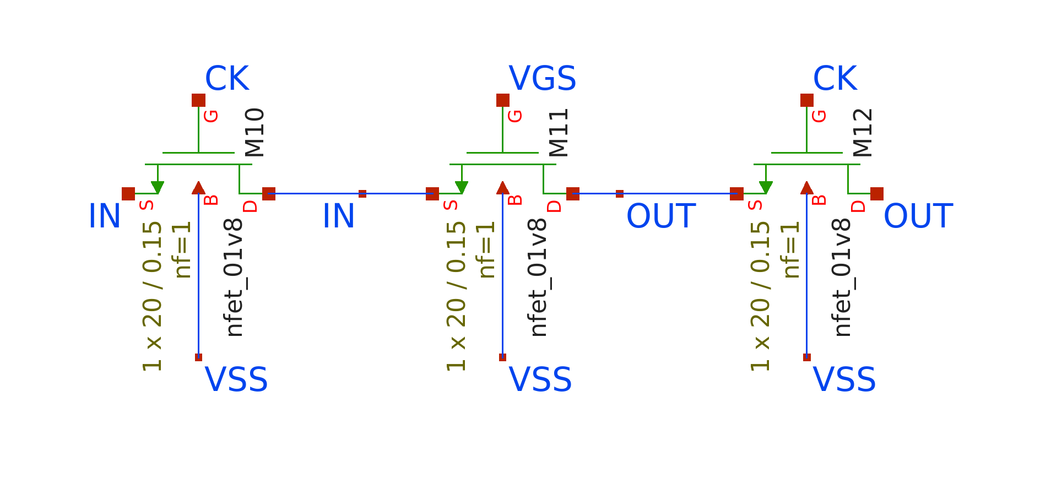
xschem/th_sw_main.png
