mthudaa/10bit_SAR-ADC_ITS/xschem/th_tb.png

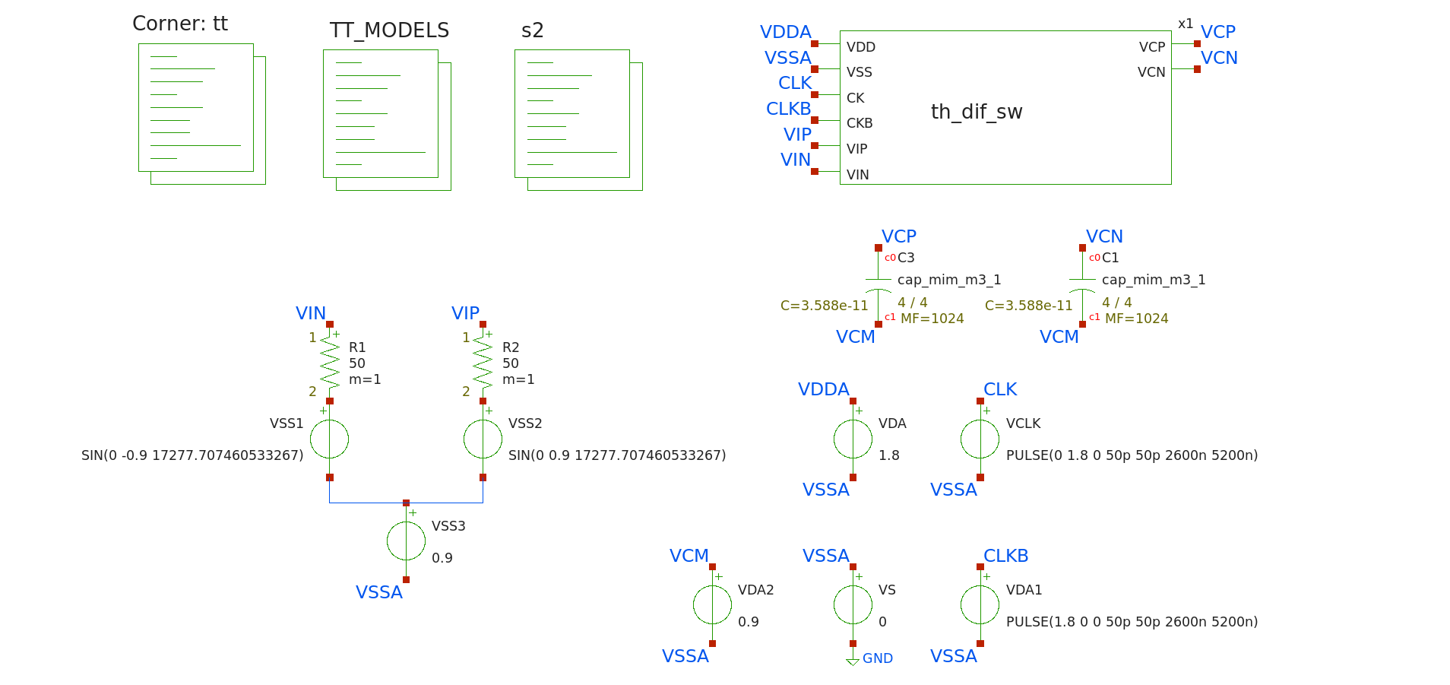
xschem/th_tb.png
