mthudaa/10bit_SAR-ADC_ITS/xschem/x10b_adc.png

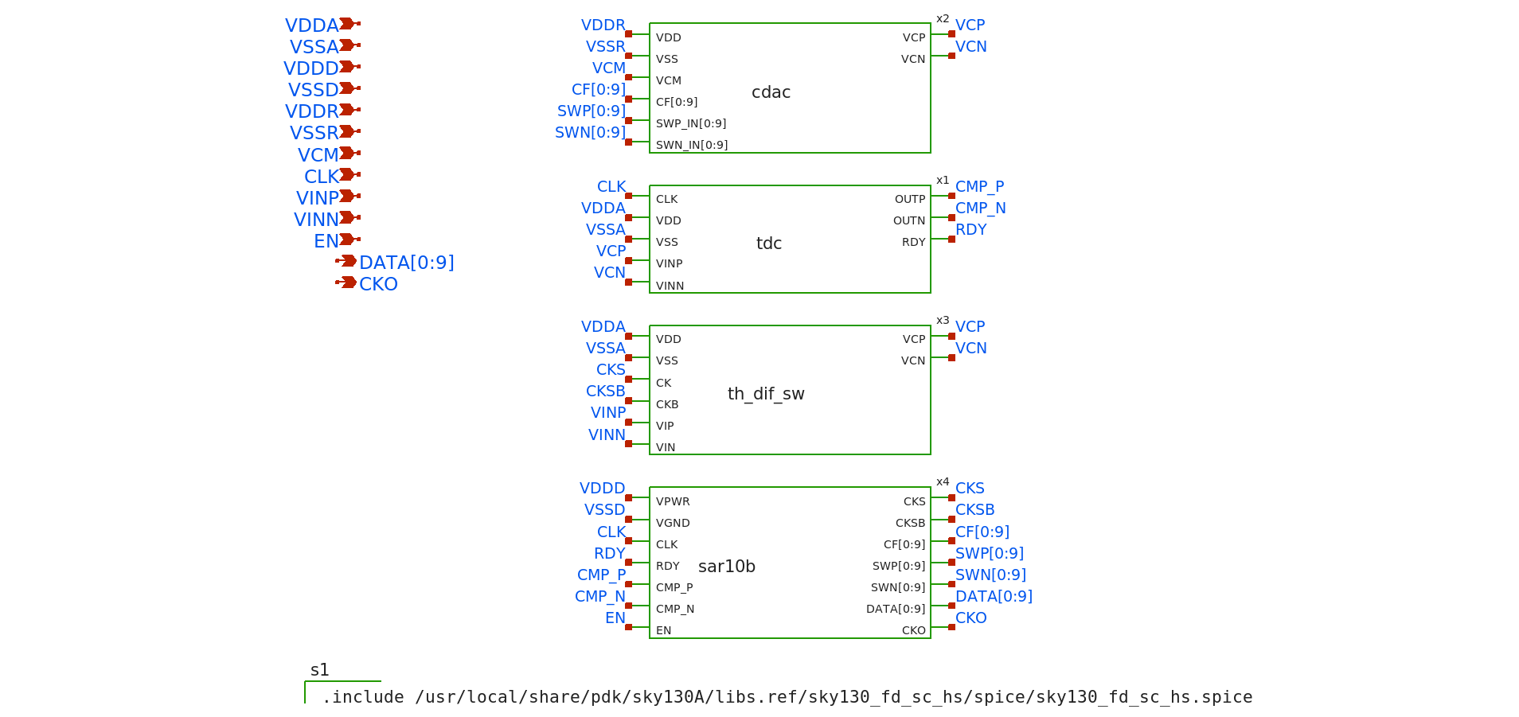
xschem/x10b_adc.png
