mthudaa/10bit_SAR-ADC_ITS/gds/klayout_printout.pdf

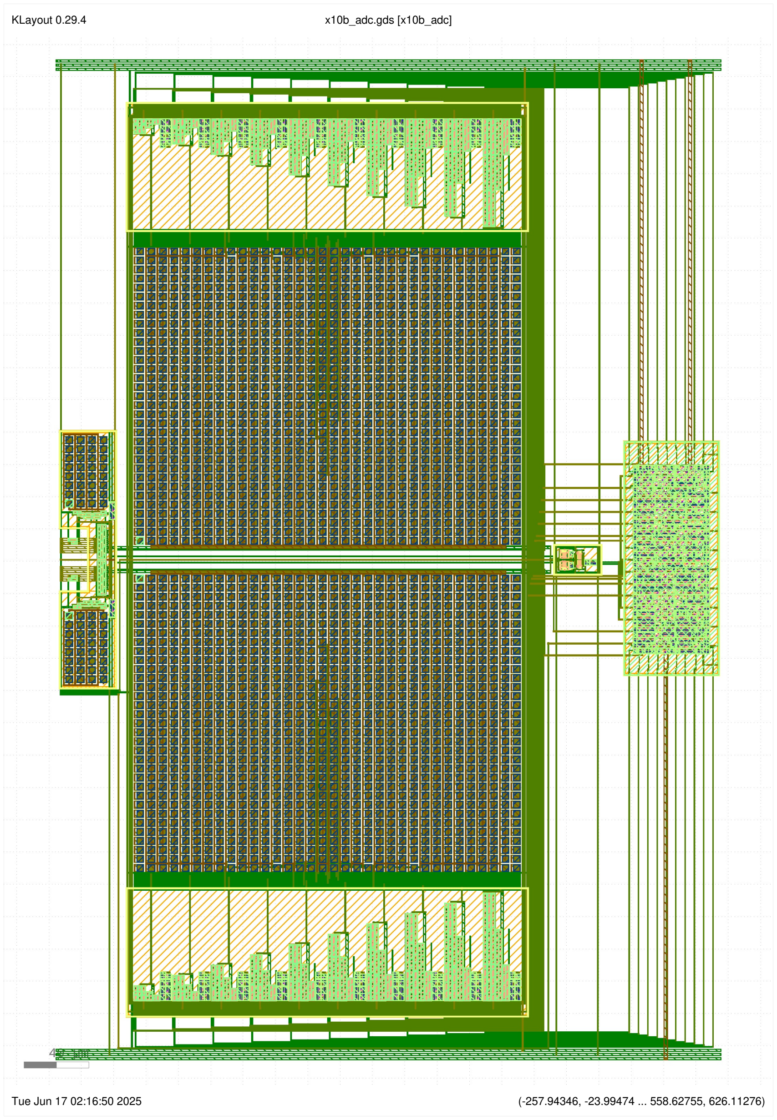
[picture p35: page 1]

KLayout 0.29.4 | x10b_adc.gds [x10b_adc]
Tue Jun 17 02:16:50 2025 | (-257.94346, -23.99474 ... 558.62755, 626.11276)
