mthudaa/10bit_SAR-ADC_ITS/xschem/sar10b.spice

* NGSPICE file created from sar10b.ext - technology: sky130A

* Black-box entry subcircuit for sky130_fd_sc_hs__fill_8 abstract view
.subckt sky130_fd_sc_hs__fill_8 VGND VNB VPB VPWR
.ends

* Black-box entry subcircuit for sky130_fd_sc_hs__dfrtp_1 abstract view
.subckt sky130_fd_sc_hs__dfrtp_1 CLK D RESET_B VGND VNB VPB VPWR Q
.ends

* Black-box entry subcircuit for sky130_fd_sc_hs__fill_2 abstract view
.subckt sky130_fd_sc_hs__fill_2 VGND VNB VPB VPWR
.ends

* Black-box entry subcircuit for sky130_fd_sc_hs__dfrtp_2 abstract view
.subckt sky130_fd_sc_hs__dfrtp_2 CLK D RESET_B VGND VNB VPB VPWR Q
.ends

* Black-box entry subcircuit for sky130_fd_sc_hs__decap_4 abstract view
.subckt sky130_fd_sc_hs__decap_4 VGND VNB VPB VPWR
.ends

* Black-box entry subcircuit for sky130_fd_sc_hs__fill_1 abstract view
.subckt sky130_fd_sc_hs__fill_1 VGND VNB VPB VPWR
.ends

* Black-box entry subcircuit for sky130_fd_sc_hs__clkbuf_1 abstract view
.subckt sky130_fd_sc_hs__clkbuf_1 A VGND VNB VPB VPWR X
.ends

* Black-box entry subcircuit for sky130_fd_sc_hs__tapvpwrvgnd_1 abstract view
.subckt sky130_fd_sc_hs__tapvpwrvgnd_1 VGND VPWR
.ends

* Black-box entry subcircuit for sky130_fd_sc_hs__and2_1 abstract view
.subckt sky130_fd_sc_hs__and2_1 A B VGND VNB VPB VPWR X
.ends

* Black-box entry subcircuit for sky130_fd_sc_hs__xor2_1 abstract view
.subckt sky130_fd_sc_hs__xor2_1 A B VGND VNB VPB VPWR X
.ends

* Black-box entry subcircuit for sky130_fd_sc_hs__clkbuf_16 abstract view
.subckt sky130_fd_sc_hs__clkbuf_16 A VGND VNB VPB VPWR X
.ends

* Black-box entry subcircuit for sky130_fd_sc_hs__nor2_1 abstract view
.subckt sky130_fd_sc_hs__nor2_1 A B VGND VNB VPB VPWR Y
.ends

* Black-box entry subcircuit for sky130_fd_sc_hs__a21bo_1 abstract view
.subckt sky130_fd_sc_hs__a21bo_1 A1 A2 B1_N VGND VNB VPB VPWR X
.ends

* Black-box entry subcircuit for sky130_fd_sc_hs__o21a_1 abstract view
.subckt sky130_fd_sc_hs__o21a_1 A1 A2 B1 VGND VNB VPB VPWR X
.ends

* Black-box entry subcircuit for sky130_fd_sc_hs__or3b_1 abstract view
.subckt sky130_fd_sc_hs__or3b_1 A B C_N VGND VNB VPB VPWR X
.ends

* Black-box entry subcircuit for sky130_fd_sc_hs__nand2_1 abstract view
.subckt sky130_fd_sc_hs__nand2_1 A B VGND VNB VPB VPWR Y
.ends

* Black-box entry subcircuit for sky130_fd_sc_hs__or4bb_1 abstract view
.subckt sky130_fd_sc_hs__or4bb_1 A B C_N D_N VGND VNB VPB VPWR X
.ends

* Black-box entry subcircuit for sky130_fd_sc_hs__clkbuf_2 abstract view
.subckt sky130_fd_sc_hs__clkbuf_2 A VGND VNB VPB VPWR X
.ends

* Black-box entry subcircuit for sky130_fd_sc_hs__buf_8 abstract view
.subckt sky130_fd_sc_hs__buf_8 A VGND VNB VPB VPWR X
.ends

* Black-box entry subcircuit for sky130_fd_sc_hs__clkbuf_4 abstract view
.subckt sky130_fd_sc_hs__clkbuf_4 A VGND VNB VPB VPWR X
.ends

* Black-box entry subcircuit for sky130_fd_sc_hs__dfxtp_4 abstract view
.subckt sky130_fd_sc_hs__dfxtp_4 CLK D VGND VNB VPB VPWR Q
.ends

* Black-box entry subcircuit for sky130_fd_sc_hs__dfxtp_1 abstract view
.subckt sky130_fd_sc_hs__dfxtp_1 CLK D VGND VNB VPB VPWR Q
.ends

* Black-box entry subcircuit for sky130_fd_sc_hs__nor3_1 abstract view
.subckt sky130_fd_sc_hs__nor3_1 A B C VGND VNB VPB VPWR Y
.ends

* Black-box entry subcircuit for sky130_fd_sc_hs__a21oi_1 abstract view
.subckt sky130_fd_sc_hs__a21oi_1 A1 A2 B1 VGND VNB VPB VPWR Y
.ends

* Black-box entry subcircuit for sky130_fd_sc_hs__and3_1 abstract view
.subckt sky130_fd_sc_hs__and3_1 A B C VGND VNB VPB VPWR X
.ends

.subckt sar10b CF[0] CF[1] CF[2] CF[3] CF[4] CF[5] CF[6] CF[7] CF[8] CF[9] CKO CKS
+ CKSB CLK CMP_N CMP_P DATA[0] DATA[1] DATA[2] DATA[3] DATA[4] DATA[5] DATA[6] DATA[7]
+ DATA[8] DATA[9] EN RDY SWN[0] SWN[1] SWN[2] SWN[3] SWN[4] SWN[5] SWN[6] SWN[7] SWN[8]
+ SWN[9] SWP[0] SWP[1] SWP[2] SWP[3] SWP[4] SWP[5] SWP[6] SWP[7] SWP[8] SWP[9] VGND
+ VPWR
XFILLER_0_3_28 VGND VGND VPWR VPWR sky130_fd_sc_hs__fill_8
X_83_ cyclic_flag_0.FINAL net38 net3 VGND VGND VPWR VPWR net18 sky130_fd_sc_hs__dfrtp_1
XFILLER_0_34_28 VGND VGND VPWR VPWR sky130_fd_sc_hs__fill_2
XFILLER_0_0_4 VGND VGND VPWR VPWR sky130_fd_sc_hs__fill_2
X_66_ net12 net1 net16 VGND VGND VPWR VPWR net35 sky130_fd_sc_hs__dfrtp_1
XFILLER_0_9_16 VGND VGND VPWR VPWR sky130_fd_sc_hs__fill_8
XFILLER_0_10_52 VGND VGND VPWR VPWR sky130_fd_sc_hs__fill_8
X_49_ net4 net14 net16 VGND VGND VPWR VPWR cyclic_flag_0.FINAL sky130_fd_sc_hs__dfrtp_2
XPHY_EDGE_ROW_28_Left_63 VGND VGND VPWR VPWR sky130_fd_sc_hs__decap_4
XPHY_EDGE_ROW_12_Left_47 VGND VGND VPWR VPWR sky130_fd_sc_hs__decap_4
XFILLER_0_6_28 VGND VGND VPWR VPWR sky130_fd_sc_hs__fill_8
XFILLER_0_13_8 VGND VGND VPWR VPWR sky130_fd_sc_hs__decap_4
XFILLER_0_16_40 VGND VGND VPWR VPWR sky130_fd_sc_hs__fill_1
Xoutput42 net42 VGND VGND VPWR VPWR SWP[4] sky130_fd_sc_hs__clkbuf_1
Xoutput31 net31 VGND VGND VPWR VPWR SWN[3] sky130_fd_sc_hs__clkbuf_1
Xoutput20 net20 VGND VGND VPWR VPWR DATA[2] sky130_fd_sc_hs__clkbuf_1
Xoutput7 net7 VGND VGND VPWR VPWR CF[2] sky130_fd_sc_hs__clkbuf_1
XTAP_TAPCELL_ROW_24_107 VGND VPWR sky130_fd_sc_hs__tapvpwrvgnd_1
XFILLER_0_7_93 VGND VGND VPWR VPWR sky130_fd_sc_hs__fill_1
XPHY_EDGE_ROW_15_Left_50 VGND VGND VPWR VPWR sky130_fd_sc_hs__decap_4
XFILLER_0_13_52 VGND VGND VPWR VPWR sky130_fd_sc_hs__fill_2
X_82_ cyclic_flag_0.FINAL net39 net3 VGND VGND VPWR VPWR net19 sky130_fd_sc_hs__dfrtp_1
XPHY_EDGE_ROW_0_Left_35 VGND VGND VPWR VPWR sky130_fd_sc_hs__decap_4
X_65_ net13 net1 net16 VGND VGND VPWR VPWR net36 sky130_fd_sc_hs__dfrtp_1
XPHY_EDGE_ROW_12_Right_12 VGND VGND VPWR VPWR sky130_fd_sc_hs__decap_4
XPHY_EDGE_ROW_21_Right_21 VGND VGND VPWR VPWR sky130_fd_sc_hs__decap_4
XPHY_EDGE_ROW_30_Right_30 VGND VGND VPWR VPWR sky130_fd_sc_hs__decap_4
XFILLER_0_10_20 VGND VGND VPWR VPWR sky130_fd_sc_hs__decap_4
X_48_ net4 net13 net16 VGND VGND VPWR VPWR net14 sky130_fd_sc_hs__dfrtp_1
XTAP_TAPCELL_ROW_18_98 VGND VPWR sky130_fd_sc_hs__tapvpwrvgnd_1
XTAP_TAPCELL_ROW_5_79 VGND VPWR sky130_fd_sc_hs__tapvpwrvgnd_1
XFILLER_0_21_52 VGND VGND VPWR VPWR sky130_fd_sc_hs__fill_2
XFILLER_0_21_63 VGND VGND VPWR VPWR sky130_fd_sc_hs__decap_4
XFILLER_0_34_4 VGND VGND VPWR VPWR sky130_fd_sc_hs__fill_2
XFILLER_0_1_40 VGND VGND VPWR VPWR sky130_fd_sc_hs__fill_8
XPHY_EDGE_ROW_6_Right_6 VGND VGND VPWR VPWR sky130_fd_sc_hs__decap_4
Xoutput43 net43 VGND VGND VPWR VPWR SWP[5] sky130_fd_sc_hs__clkbuf_1
Xoutput32 net32 VGND VGND VPWR VPWR SWN[4] sky130_fd_sc_hs__clkbuf_1
Xoutput21 net21 VGND VGND VPWR VPWR DATA[3] sky130_fd_sc_hs__clkbuf_1
Xoutput8 net8 VGND VGND VPWR VPWR CF[3] sky130_fd_sc_hs__clkbuf_1
Xoutput10 net10 VGND VGND VPWR VPWR CF[5] sky130_fd_sc_hs__clkbuf_1
XTAP_TAPCELL_ROW_24_108 VGND VPWR sky130_fd_sc_hs__tapvpwrvgnd_1
XFILLER_0_7_83 VGND VGND VPWR VPWR sky130_fd_sc_hs__fill_8
X_81_ cyclic_flag_0.FINAL net40 net3 VGND VGND VPWR VPWR net20 sky130_fd_sc_hs__dfrtp_1
XFILLER_0_13_86 VGND VGND VPWR VPWR sky130_fd_sc_hs__fill_8
XFILLER_0_0_6 VGND VGND VPWR VPWR sky130_fd_sc_hs__fill_1
XTAP_TAPCELL_ROW_12_89 VGND VPWR sky130_fd_sc_hs__tapvpwrvgnd_1
X_64_ net14 net1 net16 VGND VGND VPWR VPWR net37 sky130_fd_sc_hs__dfrtp_1
XFILLER_0_24_63 VGND VGND VPWR VPWR sky130_fd_sc_hs__fill_8
X_47_ net4 net12 net16 VGND VGND VPWR VPWR net13 sky130_fd_sc_hs__dfrtp_1
XFILLER_0_10_76 VGND VGND VPWR VPWR sky130_fd_sc_hs__decap_4
XTAP_TAPCELL_ROW_18_99 VGND VPWR sky130_fd_sc_hs__tapvpwrvgnd_1
XFILLER_0_19_41 VGND VGND VPWR VPWR sky130_fd_sc_hs__fill_8
XFILLER_0_19_63 VGND VGND VPWR VPWR sky130_fd_sc_hs__fill_2
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
XFILLER_0_29_92 VGND VGND VPWR VPWR sky130_fd_sc_hs__fill_2
XFILLER_0_31_93 VGND VGND VPWR VPWR sky130_fd_sc_hs__fill_1
XFILLER_0_15_50 VGND VGND VPWR VPWR sky130_fd_sc_hs__decap_4
XFILLER_0_26_82 VGND VGND VPWR VPWR sky130_fd_sc_hs__fill_8
XFILLER_0_6_70 VGND VGND VPWR VPWR sky130_fd_sc_hs__fill_2
XTAP_TAPCELL_ROW_28_113 VGND VPWR sky130_fd_sc_hs__tapvpwrvgnd_1
XFILLER_0_2_28 VGND VGND VPWR VPWR sky130_fd_sc_hs__fill_8
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
