mthudaa/10bit_SAR-ADC_ITS/verilog/sar10b/src/cyclic_flag.v

`timescale 1ns / 1ps
//////////////////////////////////////////////////////////////////////////////////
// Company: 
// Engineer: M Taufiqul Huda
// 
// Create Date: 24.03.2025 16:7:42
// Design Name: 
// Module Name: cyclic_flag
// Project Name: 
// Target Devices: 
// Tool Versions: 
// Description: 
// 
// Dependencies: 
// 
// Revision:
// Revision 0.01 - File Created
// Additional Comments:
// 
//////////////////////////////////////////////////////////////////////////////////


module cyclic_flag(
    input RDY,
    input CKS,
    output FINAL,
    output [0:9] CF
    );
    reg [10:0] CF_BUF;
    always @(posedge RDY or negedge CKS) begin
        if (!CKS)
            CF_BUF <= 10'b0;
        else
            CF_BUF <= {CF_BUF[10:0], CKS}; // Shift register dengan input EN
    end
    assign CF = {CF_BUF[0], CF_BUF[1], CF_BUF[2], CF_BUF[3], CF_BUF[4], CF_BUF[5], CF_BUF[6], CF_BUF[7], CF_BUF[8], CF_BUF[9]};
    assign FINAL = CF_BUF[10];
endmodule
