mthudaa/10bit_SAR-ADC_ITS/(commit log)

2025-03-18 update setelah sekian lamaaa
    [adc_tb.sch, adc_tb_static.sch, auto_sampling.sch, pd_tb.sch, phase_detector.sch, tscp.sch]
2025-03-18 update setelah sekian lamaaa 2
    [delay_gate.sch, delay_tb.sch, phase_detector.sch, tdc_tb.sch]
2025-03-18 dari pc server
    [8b_adc.sch, adc_tb.sch, dac_sw_1.sch, tdc.sch, tg_sw_1.sch, x8b_cap_array.sch]
2025-03-22 perubahan terakhir
    [adc_tb.sch, auto_sampling.sch, cyclic_flag.sch, delay_gate.sch, phase_detector.sch, tdc.sch, th_sw.sch]
2025-04-02 update tb openlane
    [adc8b_tb_open.sch, adc_tb.sch]
2025-04-14 Berhasil simulasi full
    [adc8b_tb_open.sch]
2025-04-14 update tb static
    [adc8b_tb_open_static.sch]
2025-04-17 update tb 10bit
    [8b_adc.sch, adc_tb.sch, cdac.sch, delay_gate.sch, delay_gate_test.sch, delay_tb.sch, single_8b_cdac.sch, tdc_delay_tb.sch]
2025-04-17 simulasi statik
    [adc8b_tb_open_static.sch]
2025-04-18 update tb 10bit & statik
    [adc_tb.sch, adc_tb_static.sch, cdac_sw_10.sch, cdac_sw_2.sch, cdac_sw_3.sch, cdac_sw_4.sch, cdac_sw_5.sch, cdac_sw_6.sch]
2025-04-28 update tb 10bit very fastt
    [adc_tb.sch, adc_tb_static.sch, cdac.sch, delay_gate_ori.sch, nooverlap_clk.sch, pfd.sch, phase_detector.sch, single_10b_cdac.sch]
2025-04-30 layout cicilan
    [tg_sw_1.sch, tg_sw_2.sch, tg_sw_3.sch]
2025-05-05 perubahan testbench
    [adc_tb.sch, adc_tb_static.sch, dac_sw_10.sch, dac_sw_3.sch, dac_sw_4.sch, dac_sw_5.sch, dac_sw_6.sch, dac_sw_7.sch]
2025-05-07 tambah simulasi ppg
    [adc_tb_ppg.sch]
2025-05-08 revisi thsw
    [th_dif_sw.sch, th_sw.sch, th_tb.sch]
2025-05-18 tambahan layout
    [th_sw.sch, th_tb.sch]
2025-05-19 tambahan gm id
    [delay_tb.sch, nmos1v8_sweep.sch, pmos1v8_sweep.sch]
2025-05-19 nyicil cap_array
    [nmos1v8_sweep.sch, pmos1v8_sweep.sch, x10b_cap_array.sch]
2025-05-20 perubahan presim
    [adc_tb.sch, cdac_sw_3.sch, delay_gate_ori.sch, nooverlap_clk.sch, phase_detector.sch, rc_delay_test.sch, th_dif_sw.sch]
2025-05-21 modifikasi skematik
    [adc_tb.sch, adc_tb_static.sch]
2025-05-22 modifikasi tb
    [adc_tb.sch, adc_tb_static.sch, bin_test.sch, noisetest_nfet_01v8_lvt.sch, techsweep_nfet_01v8.sch, techsweep_nfet_01v8_lvt.sch, techsweep_pfet_01v8.sch, techsweep_pfet_01v8_lvt.sch]
2025-05-25 modifikasi TH_SW 11.77 bit ENOB
    [adc_tb.sch, adc_tb_static.sch, th_sw.sch, th_tb.sch, x10b_cap_array.sch]
2025-05-26 modifikasi cap_array
    [adc_dc_sim.sch, th_sw.sch, th_tb.sch, x10b_cap_array.sch]
2025-05-31 modifikasi cap_array dan sh
    [adc_tb.sch, adc_tb_static.sch, bootstrap.sch, cdac_sw_1.sch, cdac_sw_10.sch, cdac_sw_2.sch, cdac_sw_3.sch, cdac_sw_4.sch]
2025-06-01 layout CDAC
    [cdac_sw_10b.sch, cdac_sw_3.sch, single_10b_cdac.sch]
2025-06-06 tb PPG
    [adc_tb_ppg.sch, pd_in.sch, pd_in_half.sch, pd_out.sch, phase_detector.sch]
2025-06-08 all module done
    [10b_adc.sch, 8b_adc.sch, adc_tb.sch, adc_tb_ppg.sch, adc_tb_static.sch, delay_gate_ori.sch, nooverlap_clk.sch, pd_out.sch]
2025-06-11 100% integration
    [10b_adc.sch, adc_tb.sch, adc_tb_ppg.sch, adc_tb_static.sch, pin_order.cfg, x10b_adc.sch]
2025-06-11 100% integration and pex
    [adc8b_tb_open.sch, adc8b_tb_open_static.sch, adc_dc_sim.sch, adc_tb.pex.sch, adc_tb_ppg.pex.sch, adc_tb_static.pex.sch]
2025-06-12 100% integration and pex full
    [adc_tb.pex.sch, adc_tb_static.pex.sch]
2025-06-12 100% integration and pex full pt.2
    [adc_tb.pex.sch, adc_tb_static.pex.sch]
2025-06-12 100% integration and pex full pt.3
    [adc_tb.pex.sch, adc_tb_ppg.pex.sch, adc_tb_static.pex.sch]
2025-06-12 tb PPG new
    [adc_tb.sch, adc_tb_ppg.sch, adc_tb_static.sch]
